cb285/SeniorProject/README.md

# Senior Project
# open source home automation system with raspberry pi, amazon echo, and zigbee mesh communication
