cb285/SeniorProject/hardware/electrical/Hub/Project Outputs for Hub/Hub 1.0 BOM.xlsx

Designator | LibRef | Quantity | Manufacturer | PartNumber | Rating | Value
J3, J4, J5 | J_2POSTERM_1935161 | 3 | Phoenix Contact | 1935161 | 17.5A
D2 | D_RECTBRIDGE_ABS | 1 | SMC Diode Solutions | ABS10TR | 1A
Q1, Q2, Q3 | Q_NFET_SOT23 | 3 | On Semiconductor | BSS138 | 220mA
C3, C4, C5, C6 | C_CAP_0603 | 4 | KEMET | C0603C104K5RACAUTO | 50V | .1uF
C1 | C_CAP-P_EEE-1HA101UP | 1 | Panasonic Electronic Components | EEE-1HA101UP | 50V | 100uF
K1, K2, K3 | K_G6K-2F_G6K-2F | 3 | Omron | G6K-2F-DC3 | 1A
C2 | C_CAP_0603 | 1 | Taiyo Yuden | JMK107ABJ106MA-T | 6.3V | 10uF
U1 | U_LD1117S33TR_SOT223 | 1 | STM | LD1117S33TR | 800mA | 3.3V
U3 | U_TEMPSENSE-AN_TO92 | 1 | Microchip | MCP9700T-E/TT
J2 | J_XBEE_NPPN101BFLC-RC | 1 | Sullins Connector Solutions | NPPN101BFLC-RC | 1A
U2 | U_OKI-78SR-5/1.5-W36H-C_OKI-78SR-5/1.5-W36H-C | 1 | Murata Power Solutions Inc. | OKI-78SR-5/1.5-W36H-C | 1.5A
R4, R5, R6, R7 | R_RES_0603 | 4 | Yageo | RC0603FR-0768RL | 1/10W | 68
R1, R2, R3 | R_RES_0603 | 3 | Yageo | RC0603JR-0710KL | 1/10W | 10K
J1 | J_RPI2B_ SFH11-PBPC-D20-ST-BK | 1 | Sullins Connector Solutions | SFH11-PBPC-D20-ST-BK | 3A
