cb285/SeniorProject/hardware/electrical/LightSwitch/Project Outputs for SeniorProject/Lightswitch 1.1 BOM.xlsx

Designator | LibRef | Quantity | Manufacturer | PartNumber | Rating | Value
C1, C12, C13, C15, C16 | C_CAP_0603 | 5 | Taiyo Yuden | JMK107ABJ106MA-T | 6.3V | 10uF
C2, C3, C4, C5, C6, C7, C9, C10, C11, C14, C17, C19 | C_CAP_0603 | 12 | KEMET | C0603C104K5RACAUTO | 50V | .1uF
C8 | C_CAP_1210 | 1 | Murata | GRM32ER61A107ME20L | 10V | 100uF
C18 | C_CAP-P_CAP12.5X20 | 1 | Nichicon | UVR2D470MHD1TO | 200V | 47uF
C20 | C_CAP_0603 | 1 | AVX Corporation | 06035C102KAT2A | 50V | 1nF
D1, D2 | D_LED_LED5MM | 2
D3, D4, D5, D6, D7, D8, D9, D10, D11, D15 | D_DIODE_SOD123 | 10 | Nexperia USA Inc | BAS16GWJ | 215mA
D12 | D_ZENER_SOD123 | 1 | Diodes Incorporated | BZT52C2V0-7-F | 500mW | 2V
D13 | D_RECTBRIDGE_GBU1506TB | 1 | SMC Diode Solutions | GBU1506TB | 15A
D14 | D_ZENER_SOD323 | 1 | On Semiconductor | MM3Z10VT1G | 300mW | 10V
F1 | F_FUSE_2410 | 1 | Bel Fuse | 0679H9150-05 | 350VAC | 15A
H1, H2, H3, H4, H5, H6 | H_MOUNTHOLE_MOUNTHOLE4MM | 6 |  |  |  | 4mm
J1 | J_RIBBCONN_RIBBCONN | 1
J2 | J_XBEE_NPPN101BFLC-RC | 1 | Sullins Connector Solutions | NPPN101BFLC-RC | 1A
J3, J4 | J_2POSTERM_1935161 | 2 | Phoenix Contact | 1935161 | 17.5A
K1 | K_RELAY-RZ03-1A4_RZ03-1A4-D005 | 1 | TE Connectivity / Potter and Brumfield | RZ03-1A4-D005 | 16A
Q1 | Q_NFET_SOT23 | 1 | On Semiconductor | BSS138 | 220mA
Q2 | Q_NFET_TO252 | 1 | Infineon Technologies | IPD50R280CEAUMA1 | 18.1A
R1 | R_RES_0603 | 1 | Yageo | RC0603JR-07470KL | 1/10W | 470K
R2, R4, R5, R6, R8, R10, R11, R12, R17, R20 | R_RES_0603 | 10 | Yageo | RC0603JR-0710KL | 1/10W | 10K
R3, R9, R18 | R_RES_0603 | 3 | Yageo | RC0603JR-07180RL | 1/10W | 180
R7, R19 | R_RES_0603 | 2 | Yageo | RC0603FR-07806KL | 1/10W | 806K
R13, R22 | R_RES_0603 | 2 | Yageo | RC0603FR-07196KL | 1/10W | 196K
R14, R23 | R_RES_0603 | 2 | Yageo | RC0603FR-071K62L | 1/10W | 1.62K
R15 | R_RES_0603 | 1 | Yageo | RC0603FR-071ML | 1/10W | 1M
R16 | R_RES_0603 | 1 | Yageo | RC0603FR-07280KL | 1/10W | 280K
R21 | R_RES_0603 | 1 | Yageo | RC0603FR-072K49L | 1/10W | 2.49K
R24 | R_RES_1206 | 1 | Yageo | RC1206JR-07100KL | 1/4W | 100K
T1, T2, T3, T4, T5, T6, T8, T9, T12, T13, T15, T17, T18, T19, T20, T21, T22, T23, T24, T25 | T_TESTPOINT_TESTPOINT1MM | 20 |  |  |  | 1mm
T7, T10, T11, T14, T16 | T_TESTPOINT_TESTPOINT2.5MM | 5 |  |  |  | 2.54mm
U1 | U_DUALDFLIP_SOIC14 | 1 | TI | SN74HCT74DR
U2 | U_DS4301_MSOP8 | 1 | Maxim | DS4301 |  | 200K
U3 | U_SN74HCT04DR_SOIC14 | 1 | TI | SN74HCT04DR
U4 | U_LTC6992CS6-2_SOT23-6 | 1 | Linear | LTC6992CS6-2
U5 | U_LD1117S33TR_SOT223 | 1 | STM | LD1117S33TR | 800mA | 3.3V
U6 | U_MCT275_DIP6 | 1 | Vishay | MCT275
U7 | U_ACS712_SOIC8 | 1 | Allegro MicroSystems, LLC | ACS712ELCTR-20A-T | 20A
U8 | U_IRM-02-5_IRM-02-5 | 1 |  | IRM-02-5 | 400mA | 5V
