cb285/SeniorProject/hardware/electrical/Hub/Models/EEE-1HA101UP.STEP

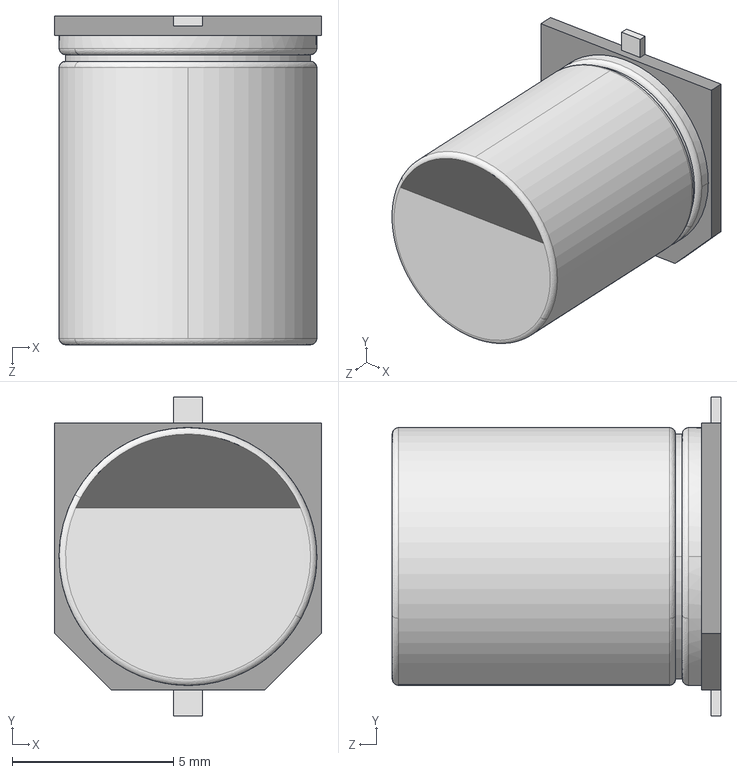
[picture p1: CAD file, 2018-03-21]
hardware/electrical/Hub/Models/EEE-1HA101UP.STEP
8.30 x 9.90 x 10.2 mm
