cb285/SeniorProject/hardware/electrical/LightSwitch/Models/IRM-02-5.stp

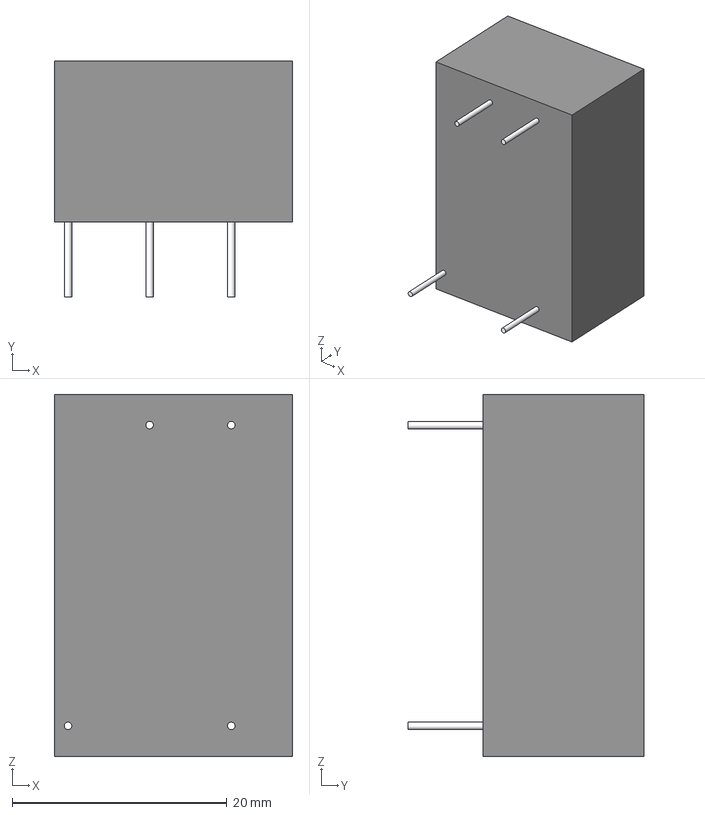
[picture p2: CAD file, 2018-03-12]
hardware/electrical/LightSwitch/Models/IRM-02-5.stp
22.2 x 22.0 x 33.7 mm
