cb285/SeniorProject/hardware/mechanical/Hub/Hub Enclosure Front 1.1.stl

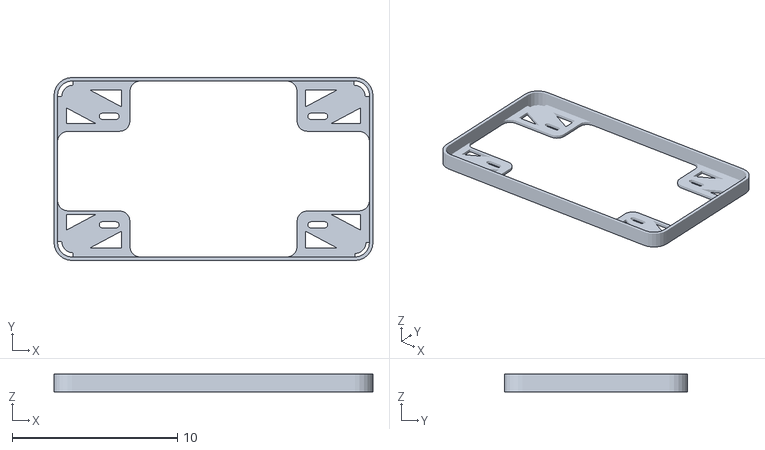
[picture p3: CAD file, 2018-04-02]
hardware/mechanical/Hub/Hub Enclosure Front 1.1.stl
19.3 x 11.1 x 1.06
