cb285/SeniorProject/hardware/mechanical/LightSwitch/LightSwitchCover 1.1.stl

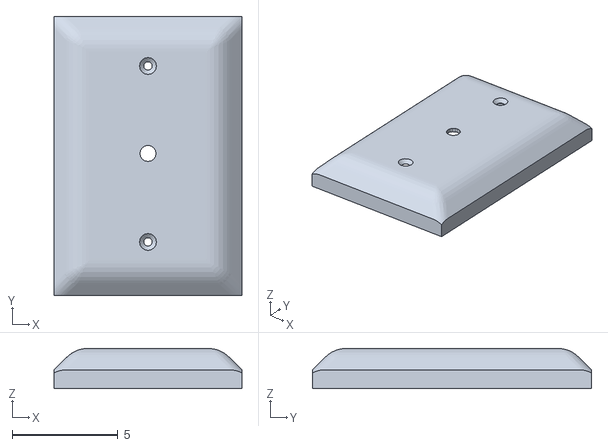
[picture p4: CAD file, 2018-03-27]
hardware/mechanical/LightSwitch/LightSwitchCover 1.1.stl
8.89 x 13.2 x 1.90
