cb285/SeniorProject/hardware/electrical/Hub/Models/ABS.step

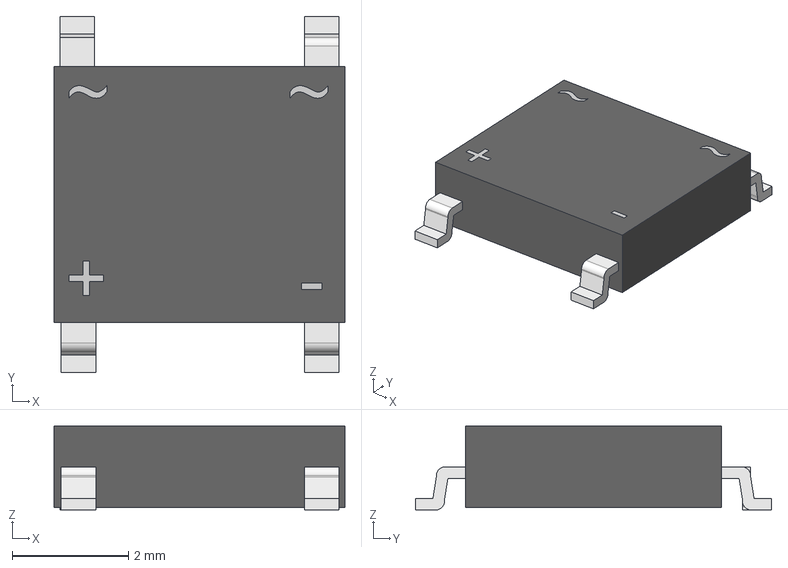
[picture p5: CAD file, 2018-03-21]
hardware/electrical/Hub/Models/ABS.step
5.00 x 6.12 x 1.46 mm
Würfel
Würfel002
Würfel003
Würfel001
ShapeString
ShapeString001
ShapeString002
ShapeString003
