cb285/SeniorProject/hardware/electrical/LightSwitch/Models/SOD323.stp

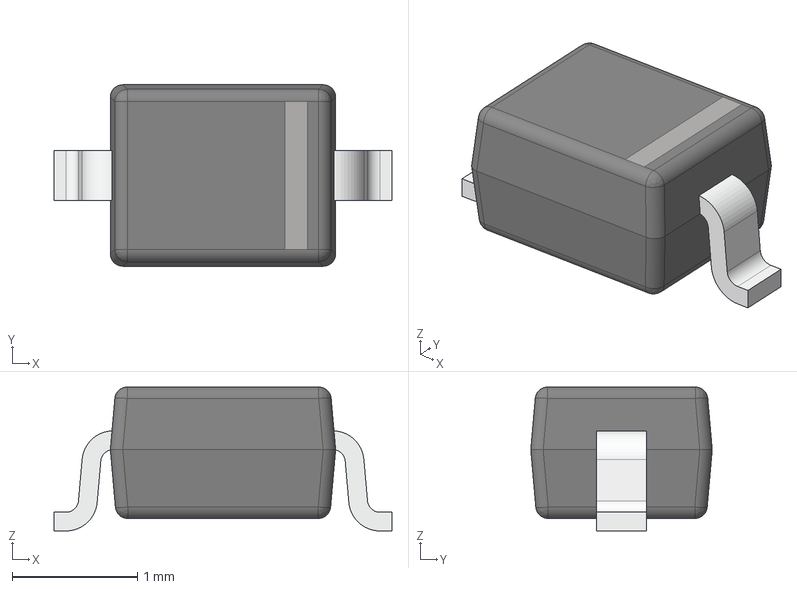
[picture p6: CAD file, 2018-03-12]
hardware/electrical/LightSwitch/Models/SOD323.stp
2.70 x 1.45 x 1.15 mm
