cb285/SeniorProject/hardware/mechanical/LightSwitch/EncoderDaughter.step

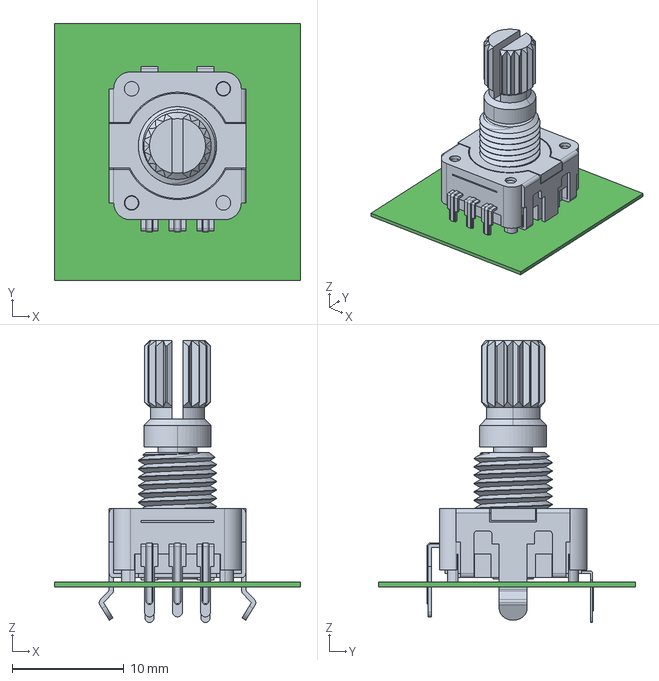
[picture p8: CAD file, 2018-03-16]
hardware/mechanical/LightSwitch/EncoderDaughter.step
22.0 x 23.0 x 25.2 mm
Board
pec11r-4215k-n0024
