cb285/SeniorProject/hardware/electrical/Hub/Models/G6K_2F.step

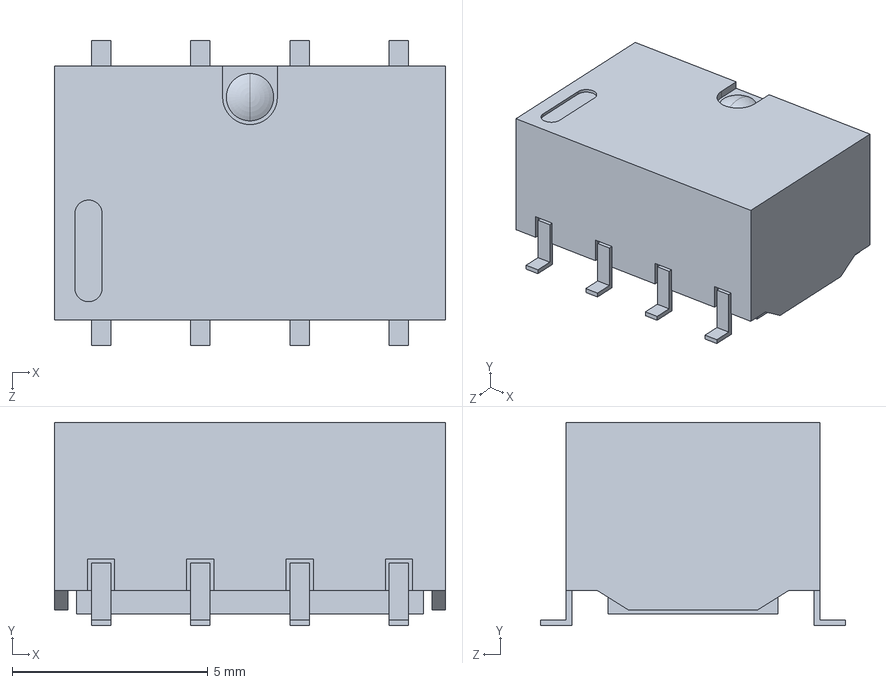
[picture p9: CAD file, 2018-03-21]
hardware/electrical/Hub/Models/G6K_2F.step
10.0 x 5.20 x 7.80 mm
