cb285/SeniorProject/hardware/electrical/LightSwitch/Models/0679H.stp

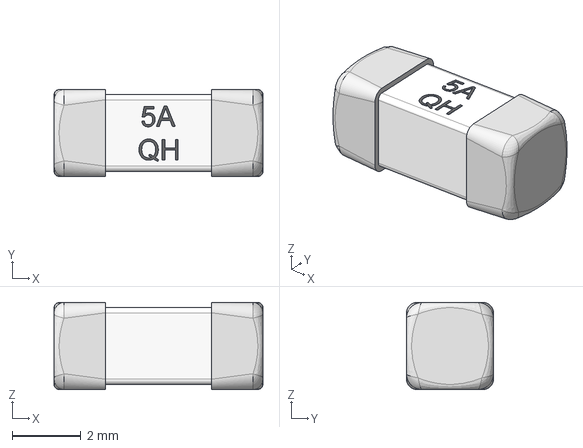
[picture p10: CAD file, 2018-03-12]
hardware/electrical/LightSwitch/Models/0679H.stp
6.10 x 2.54 x 2.54 mm
