cb285/SeniorProject/hardware/electrical/Hub/Models/OKI-78SR-51.5-W36H-C.step

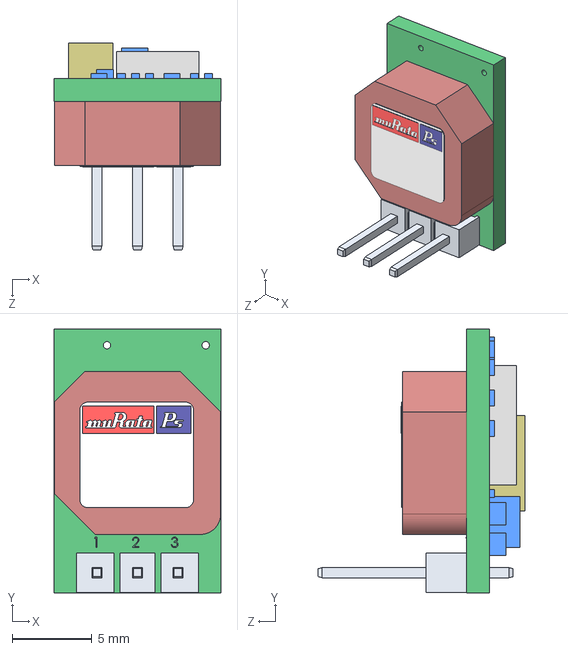
[picture p12: CAD file, 2018-03-21]
hardware/electrical/Hub/Models/OKI-78SR-51.5-W36H-C.step
10.4 x 16.5 x 12.9 mm
