cb285/SeniorProject/hardware/electrical/LightSwitch/Models/LED5MM.STEP

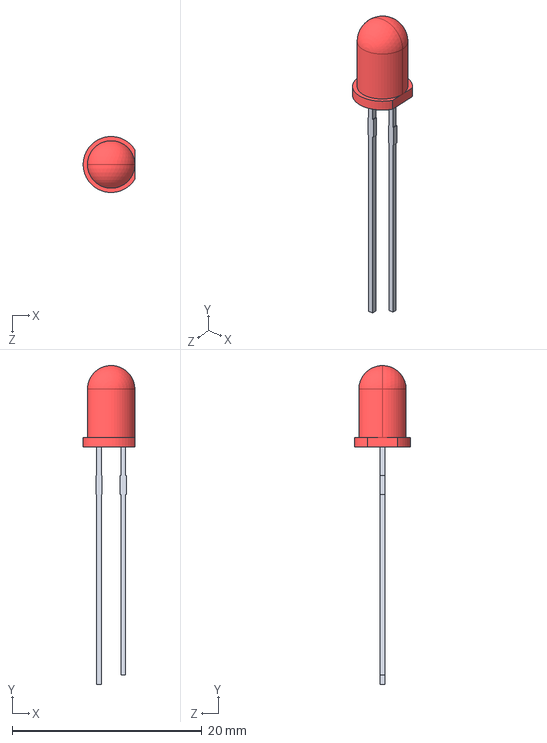
[picture p13: CAD file, 2018-03-12]
hardware/electrical/LightSwitch/Models/LED5MM.STEP
5.45 x 33.6 x 5.90 mm
