cb285/SeniorProject/hardware/mechanical/LightSwitch/1GangSwitchBox.STEP

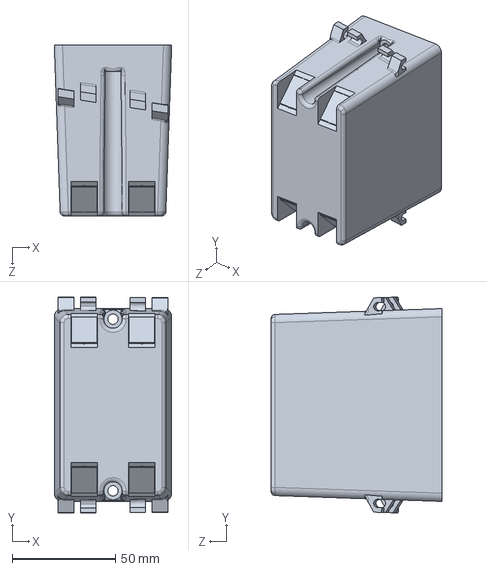
[picture p14: CAD file, 2018-03-12]
hardware/mechanical/LightSwitch/1GangSwitchBox.STEP
57.0 x 104.8 x 82.9 mm
