cb285/SeniorProject/hardware/electrical/Hub/Models/DO15.STEP

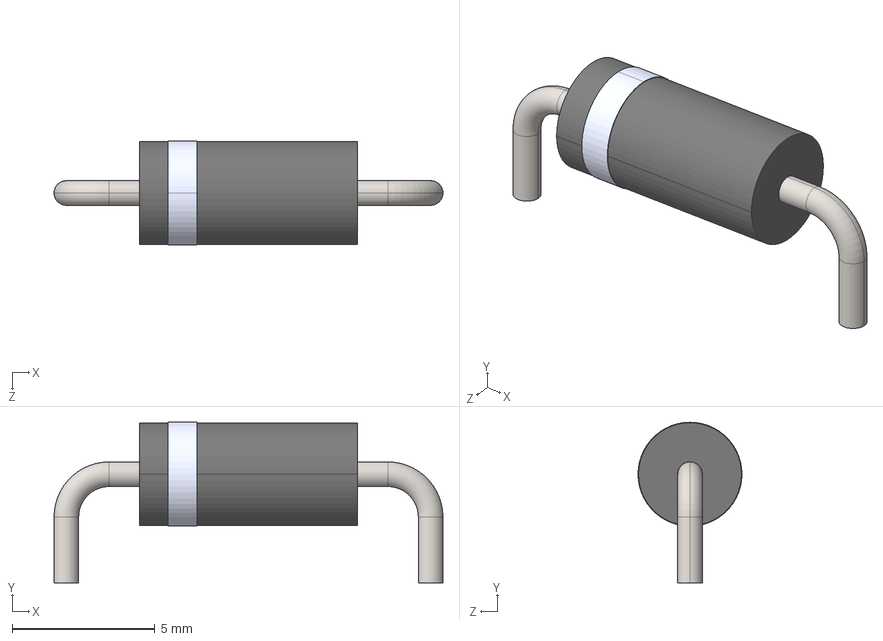
[picture p15: CAD file, 2018-03-21]
hardware/electrical/Hub/Models/DO15.STEP
13.6 x 5.62 x 3.64 mm
