cb285/SeniorProject/hardware/electrical/LightSwitch/Models/RZ03-1A4-D005.stp

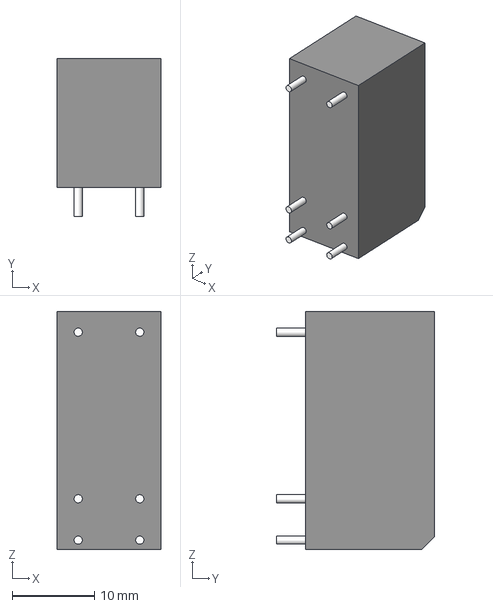
[picture p16: CAD file, 2018-03-12]
hardware/electrical/LightSwitch/Models/RZ03-1A4-D005.stp
12.7 x 19.2 x 29.0 mm
