cb285/SeniorProject/hardware/mechanical/LightSwitch/PEC11-4215F-S24.stp

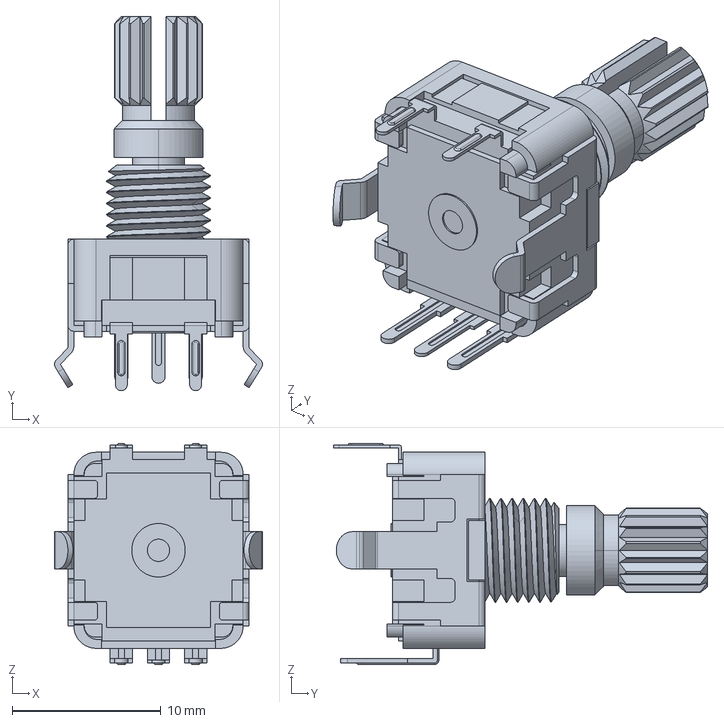
[picture p17: CAD file, 2018-02-16]
hardware/mechanical/LightSwitch/PEC11-4215F-S24.stp
14.0 x 25.2 x 14.9 mm
