cb285/SeniorProject/hardware/electrical/Hub/Models/CAP10X20.step

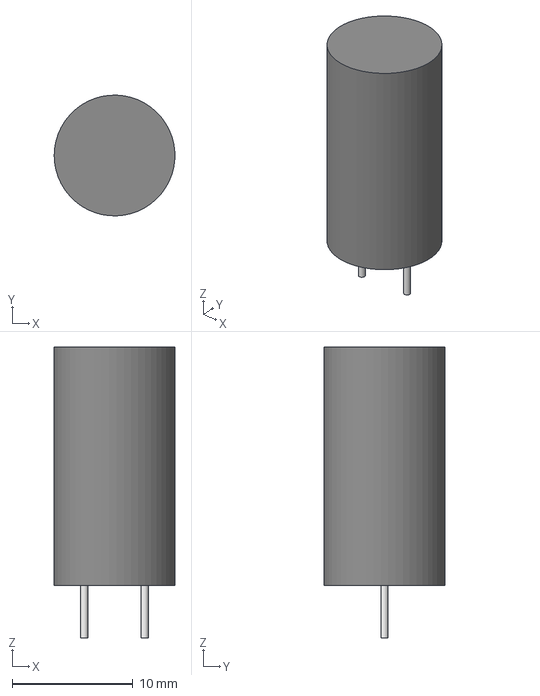
[picture p18: CAD file, 2018-03-17]
hardware/electrical/Hub/Models/CAP10X20.step
10.00 x 10.0 x 24.1 mm
