cb285/SeniorProject/hardware/electrical/LightSwitch/Models/AC1015.stp

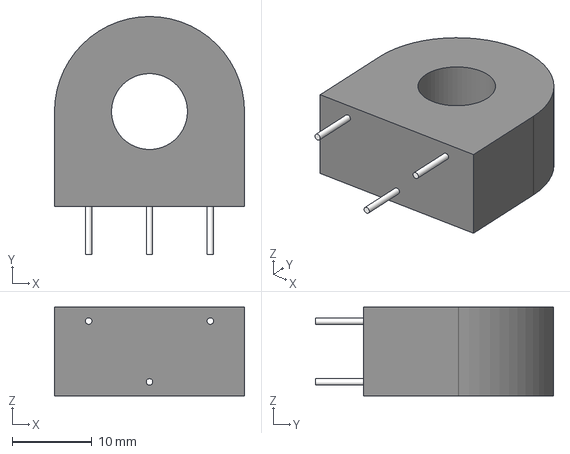
[picture p19: CAD file, 2018-03-12]
hardware/electrical/LightSwitch/Models/AC1015.stp
23.8 x 29.8 x 11.1 mm
