cb285/SeniorProject/hardware/electrical/Hub/Models/SIOC8.stp

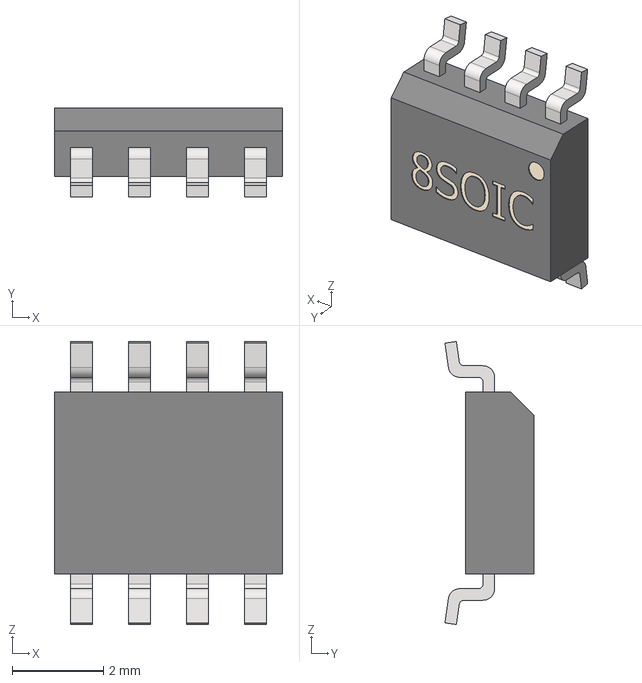
[picture p20: CAD file, 2018-03-17]
hardware/electrical/Hub/Models/SIOC8.stp
5.00 x 1.95 x 6.20 mm
8SOIC_BODY
8SOIC_PIN x 8
