cb285/SeniorProject/hardware/electrical/LightSwitch/Models/SOT23.step

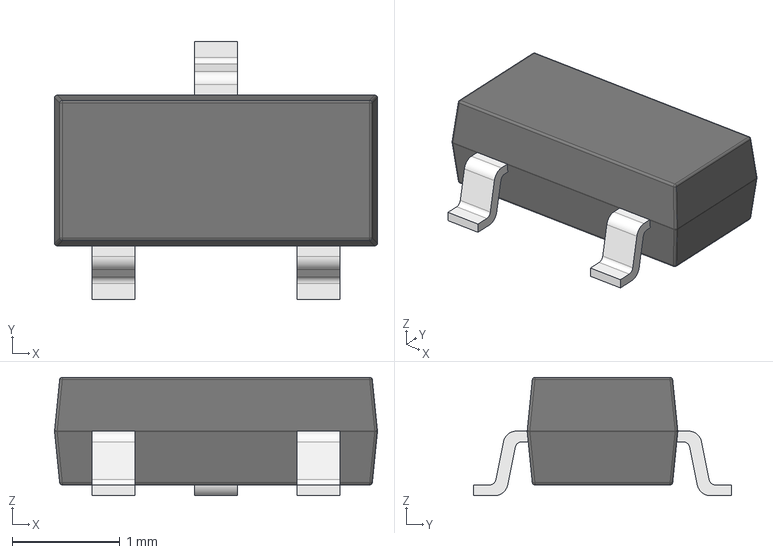
[picture p21: CAD file, 2018-03-12]
hardware/electrical/LightSwitch/Models/SOT23.step
3.00 x 2.40 x 1.10 mm
pin x 3
