cb285/SeniorProject/hardware/electrical/LightSwitch/Models/NPPN101BFLC-RC.STEP

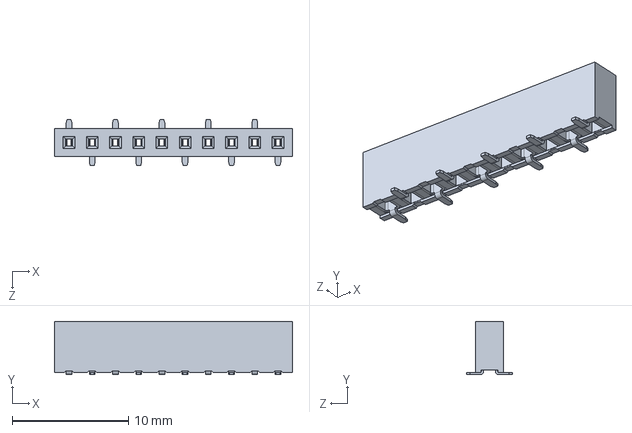
[picture p22: CAD file, 2018-03-12]
hardware/electrical/LightSwitch/Models/NPPN101BFLC-RC.STEP
20.5 x 4.60 x 4.00 mm
