cb285/SeniorProject/hardware/electrical/LightSwitch/Models/SOD123.stp

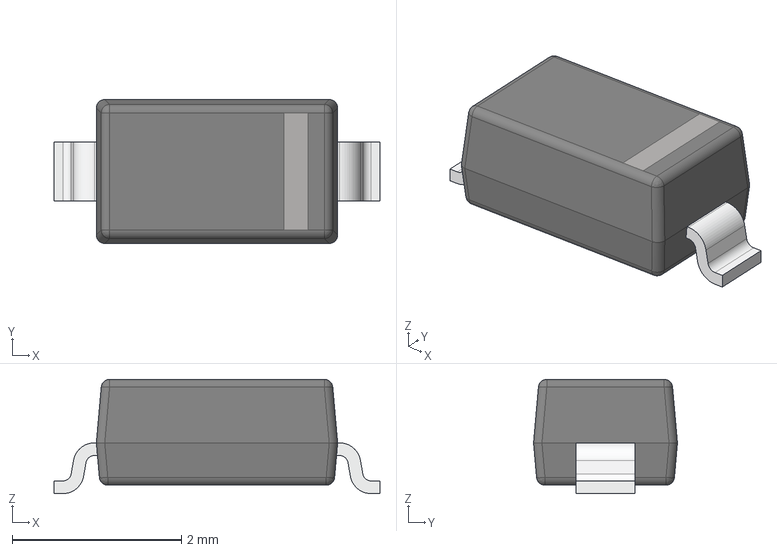
[picture p23: CAD file, 2018-03-12]
hardware/electrical/LightSwitch/Models/SOD123.stp
3.85 x 1.70 x 1.35 mm
