cb285/SeniorProject/hardware/electrical/LightSwitch/Models/GBU.STEP

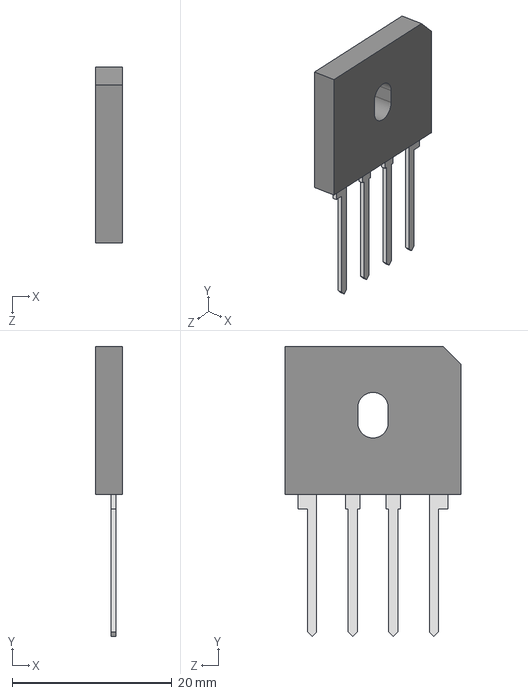
[picture p24: CAD file, 2018-03-12]
hardware/electrical/LightSwitch/Models/GBU.STEP
3.43 x 36.3 x 22.1 mm
