cb285/SeniorProject/hardware/electrical/LightSwitch/Models/SOIC14.stp

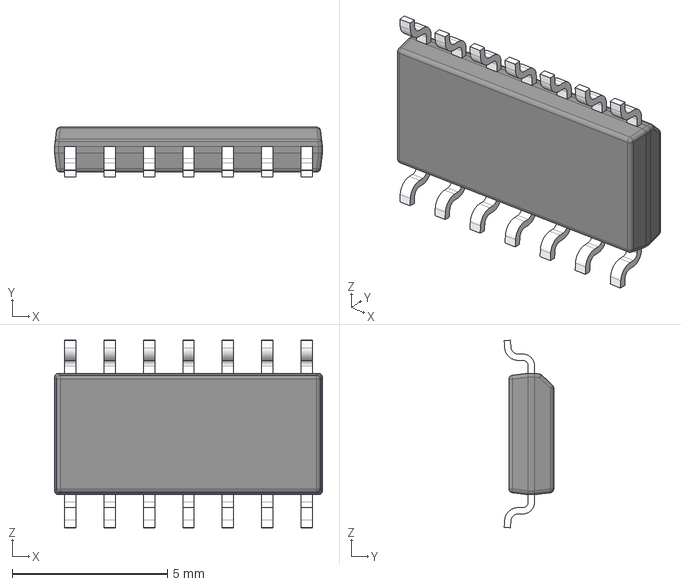
[picture p25: CAD file, 2018-03-12]
hardware/electrical/LightSwitch/Models/SOIC14.stp
8.64 x 1.60 x 6.05 mm
BODY_M14A_20
LEAD_M14A_46 x 14
