cb285/SeniorProject/hardware/electrical/LightSwitch/Models/RES1206.STEP

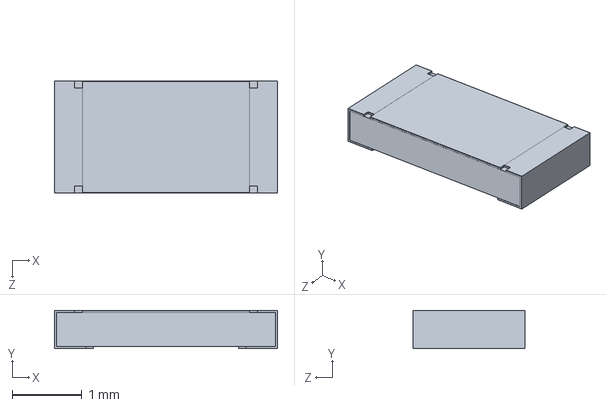
[picture p26: CAD file, 2018-02-21]
hardware/electrical/LightSwitch/Models/RES1206.STEP
3.20 x 0.55 x 1.61 mm
