cb285/SeniorProject/hardware/electrical/LightSwitch/Models/DIP16-4.stp

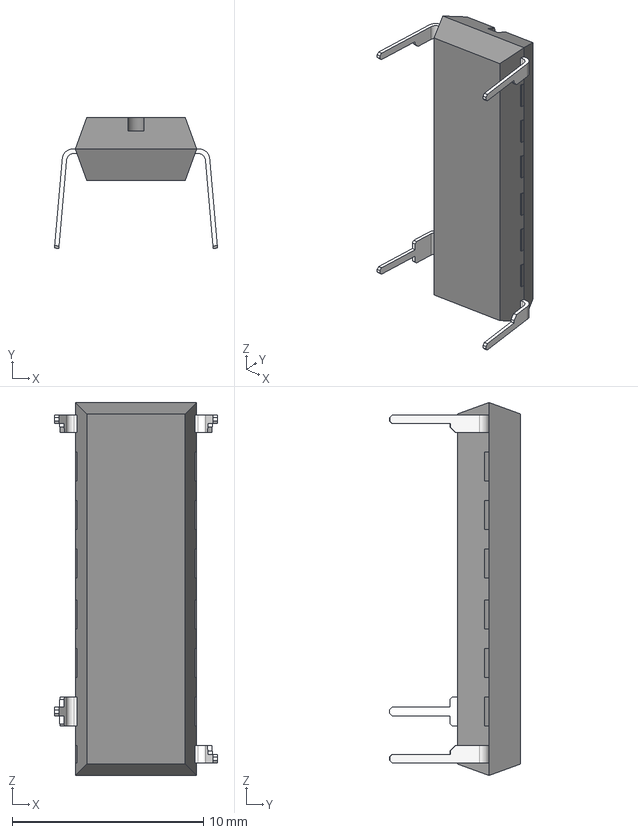
[picture p27: CAD file, 2018-02-21]
hardware/electrical/LightSwitch/Models/DIP16-4.stp
8.53 x 6.85 x 19.5 mm
