cb285/SeniorProject/hardware/electrical/LightSwitch/Models/msop-8.SLDPRT

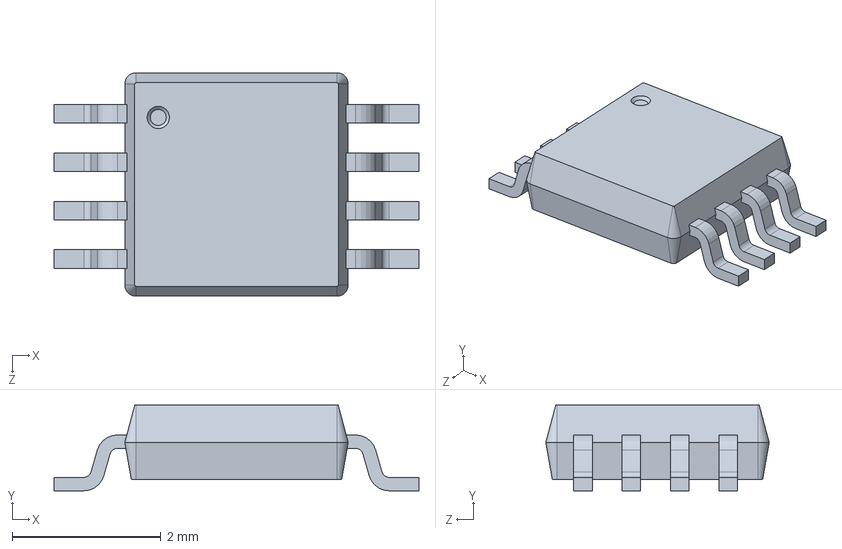
[picture p28: CAD file, 2018-02-21]
hardware/electrical/LightSwitch/Models/msop-8.SLDPRT
4.90 x 1.15 x 3.00 mm
