cb285/SeniorProject/hardware/electrical/LightSwitch/Models/CAP12.5X20.stp

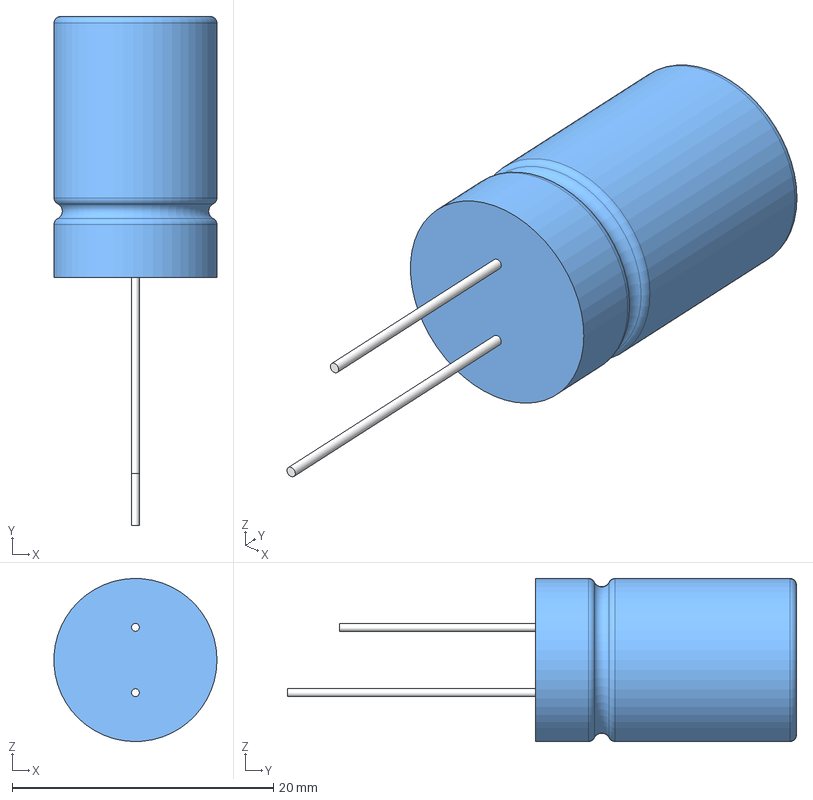
[picture p29: CAD file, 2018-02-21]
hardware/electrical/LightSwitch/Models/CAP12.5X20.stp
12.5 x 39.0 x 12.5 mm
