cb285/SeniorProject/hardware/electrical/LightSwitch/Models/0603.STEP

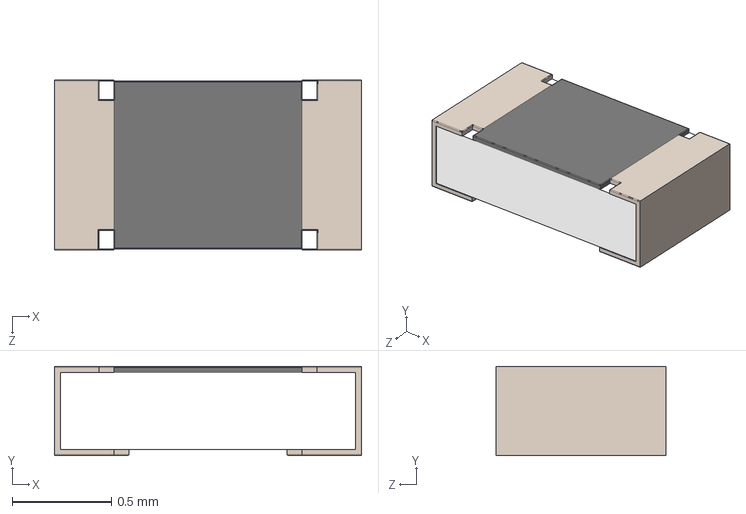
[picture p30: CAD file, 2018-02-21]
hardware/electrical/LightSwitch/Models/0603.STEP
1.55 x 0.45 x 0.86 mm
