cb285/SeniorProject/(list of files, cad)

Other CAD files:
hardware/mechanical/LightSwitch/LightSwitchCover 1.0.stl
hardware/mechanical/Hub/Hub Enclosure Front 1.0.stl
hardware/electrical/LightSwitch/Models/AC1015.ipt
hardware/electrical/LightSwitch/Models/CAP12.5X20.ipt
hardware/electrical/LightSwitch/Models/DIP16-4.ipt
hardware/electrical/LightSwitch/Models/IRM-02-5.ipt
hardware/electrical/LightSwitch/Models/RZ03-1A4-D005.ipt
hardware/electrical/LightSwitch/Models/m20-9980345_asm.stp
hardware/mechanical/Hub/1GangSwitchBox.ipt
hardware/mechanical/Hub/Hub Enclosure Back.ipt
hardware/mechanical/Hub/Hub Enclosure Front (new).ipt
hardware/mechanical/Hub/Hub Enclosure Front.ipt
hardware/mechanical/Hub/Standoff.ipt
hardware/mechanical/Hub/Touchscreen PCB.ipt
hardware/mechanical/Hub/Touchscreen.ipt
hardware/mechanical/LightSwitch/LightSwitchCover.ipt
hardware/mechanical/LightSwitchAssembly.iam
