cb285/SeniorProject/hardware/mechanical/Hub/HubAssembly-Exploded.png

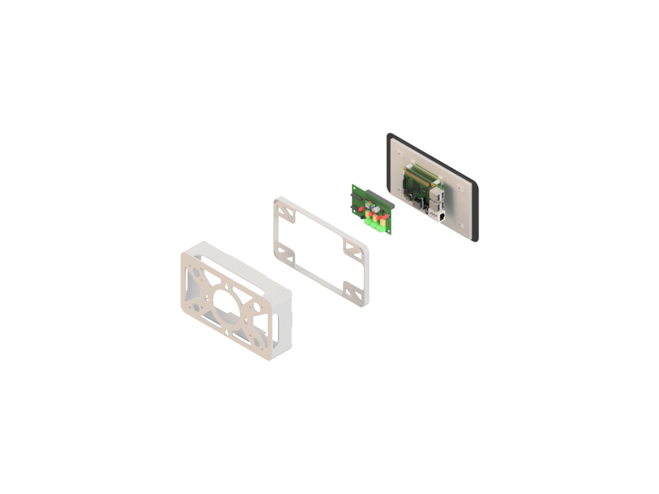
hardware/mechanical/Hub/HubAssembly-Exploded.png
