cb285/SeniorProject/hardware/mechanical/Hub/HubAssembly.png

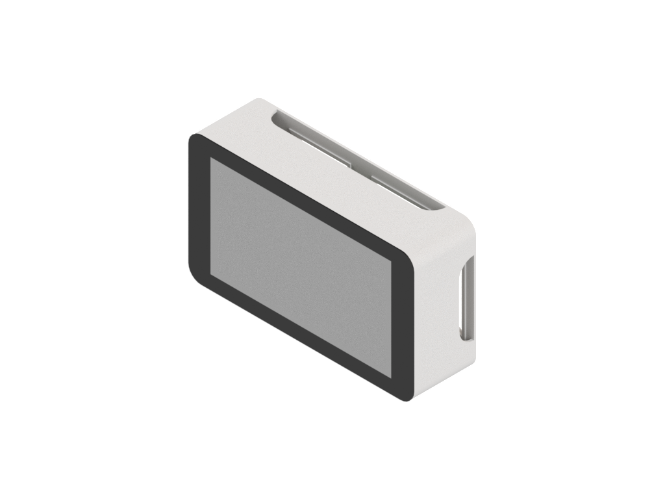
hardware/mechanical/Hub/HubAssembly.png
