cb285/SeniorProject/hardware/mechanical/LightSwitch/LightSwitchAssembly-Exploded.png

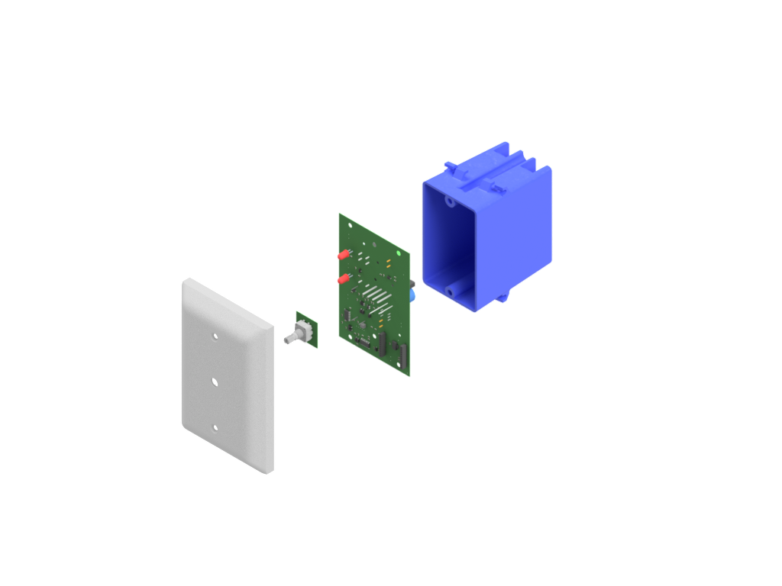
hardware/mechanical/LightSwitch/LightSwitchAssembly-Exploded.png
