cb285/SeniorProject/hardware/mechanical/LightSwitch/LightSwitchAssembly.png

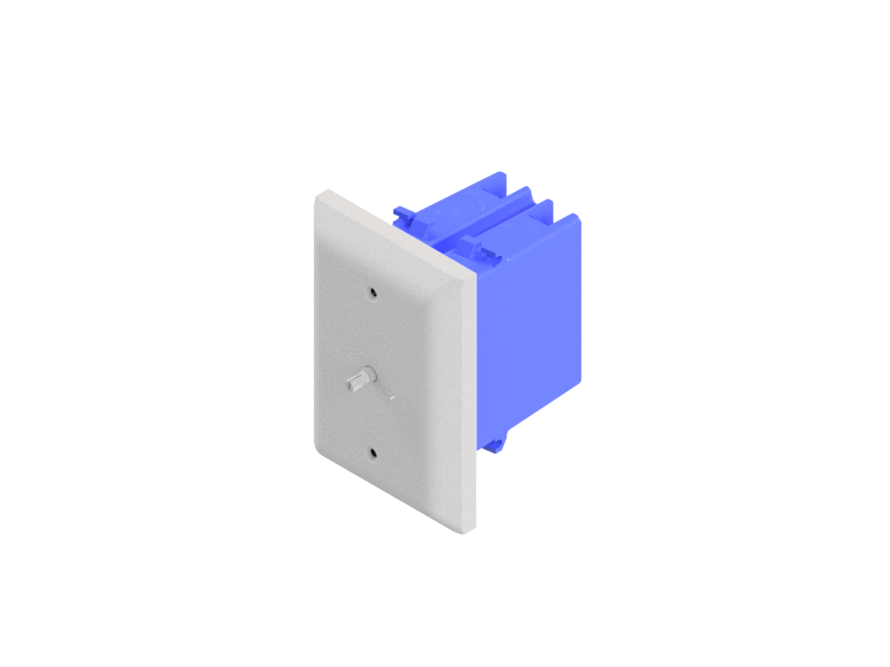
hardware/mechanical/LightSwitch/LightSwitchAssembly.png
