cb285/SeniorProject/hardware/electrical/Hub/Project Outputs for Hub/Hub.PDF

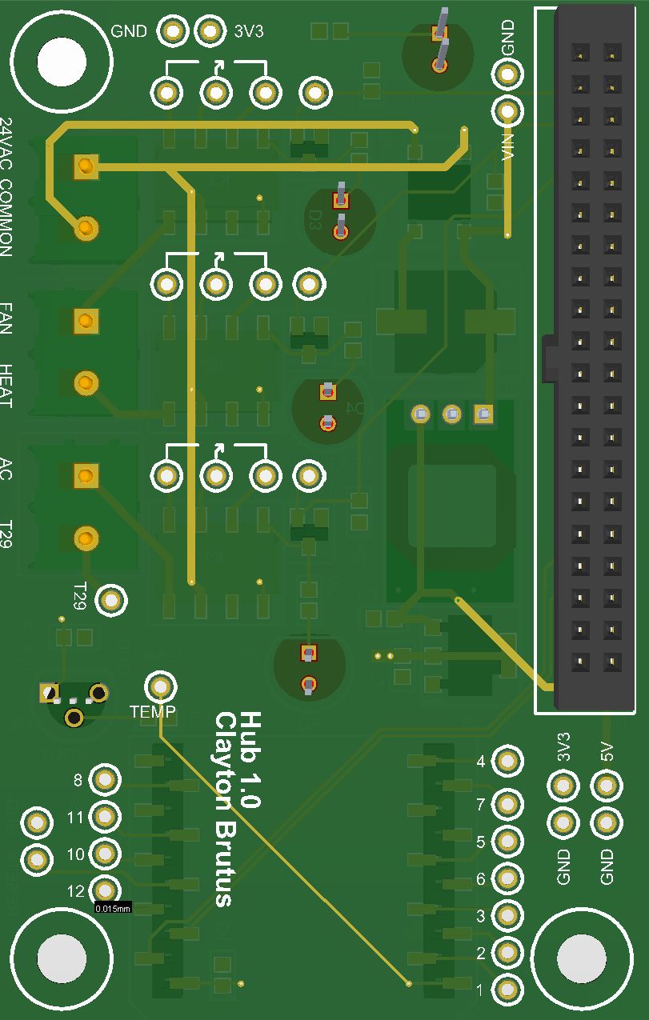
[picture p35: page 1]

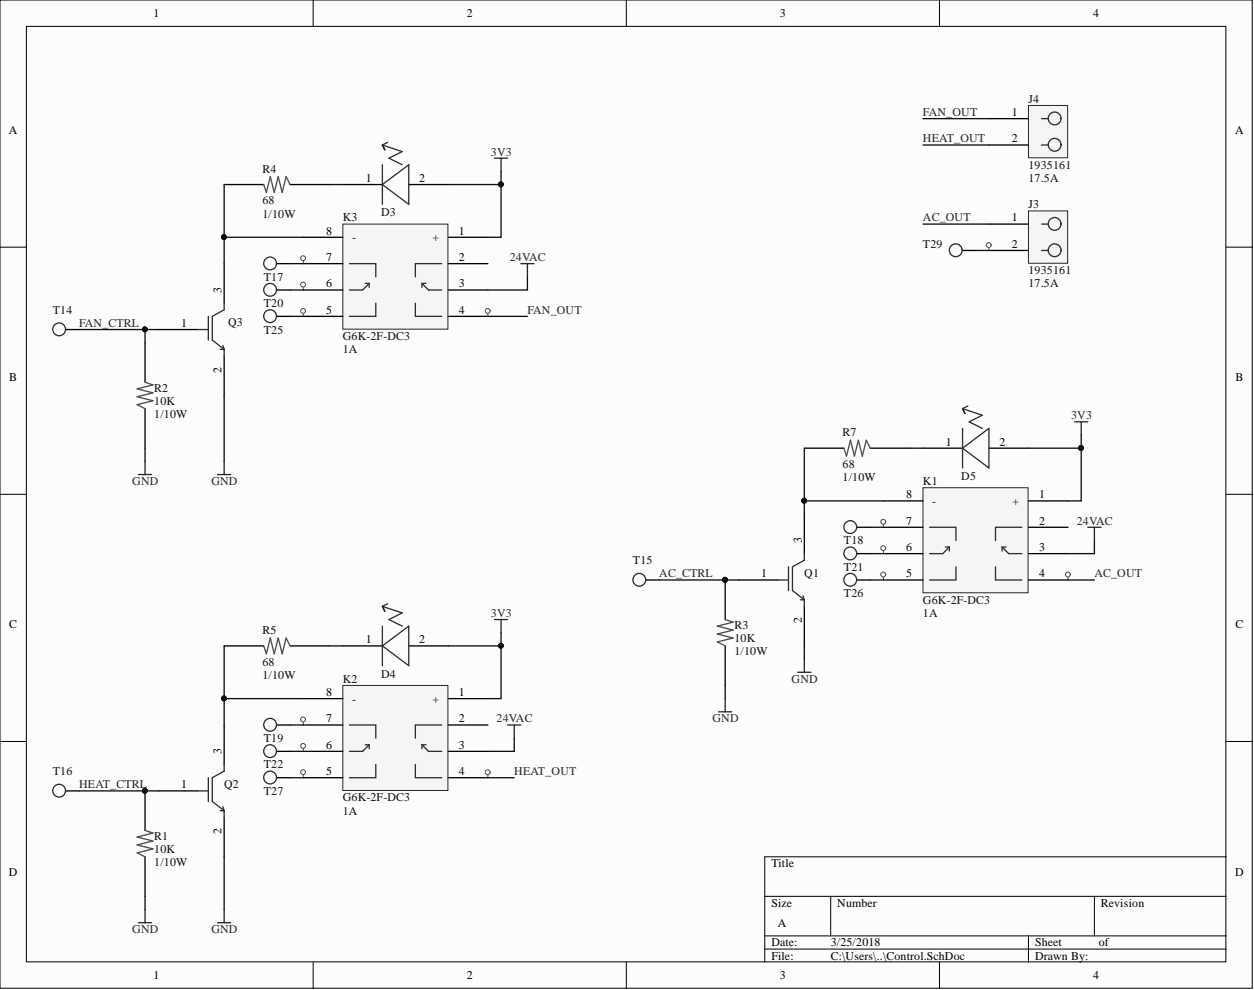
[picture p36: page 3]

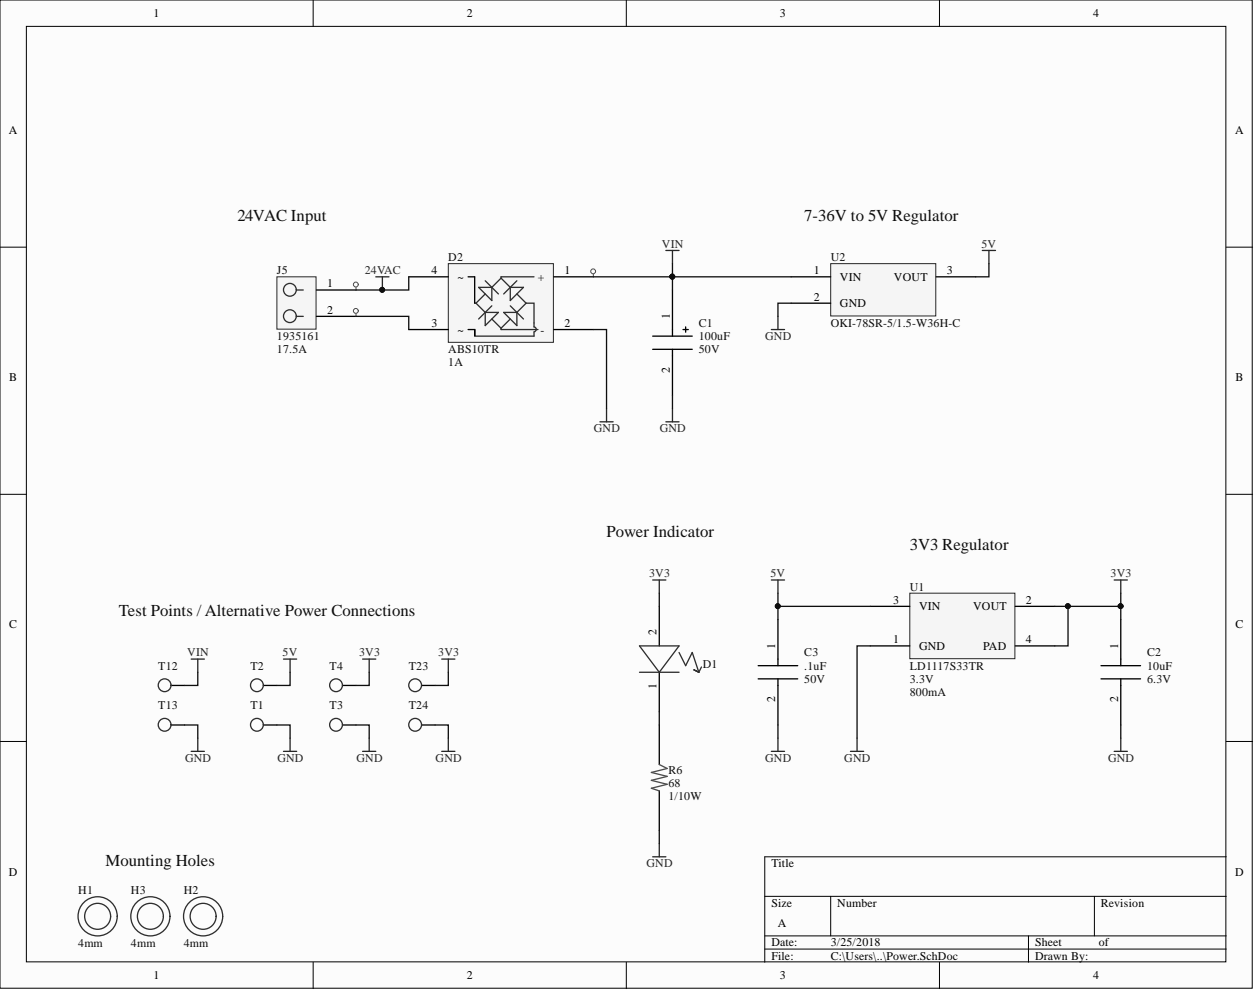
[picture p37: page 4]

Test Points / Alternative Power Connections

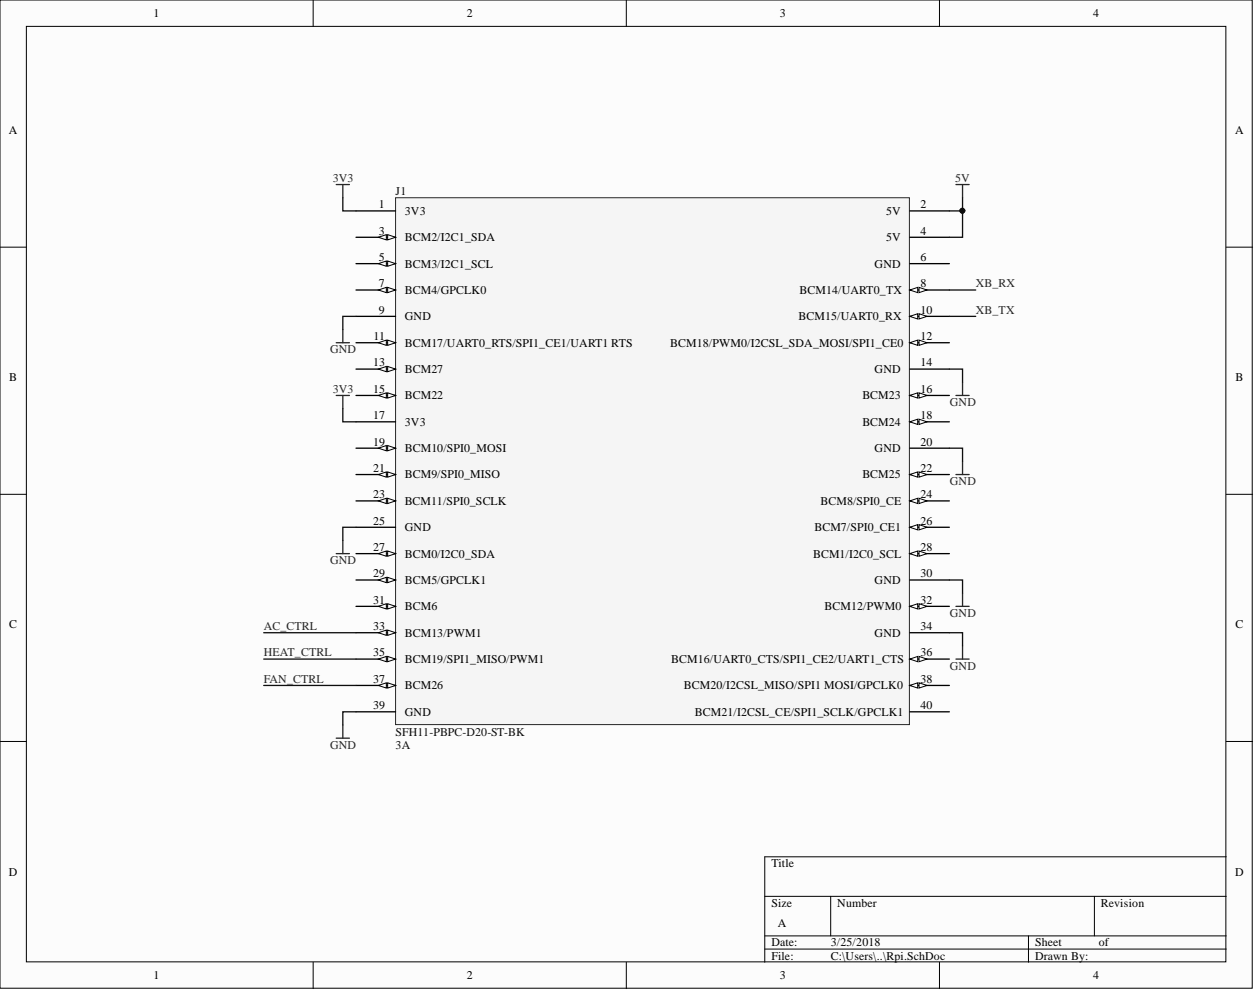
[picture p38: page 5]

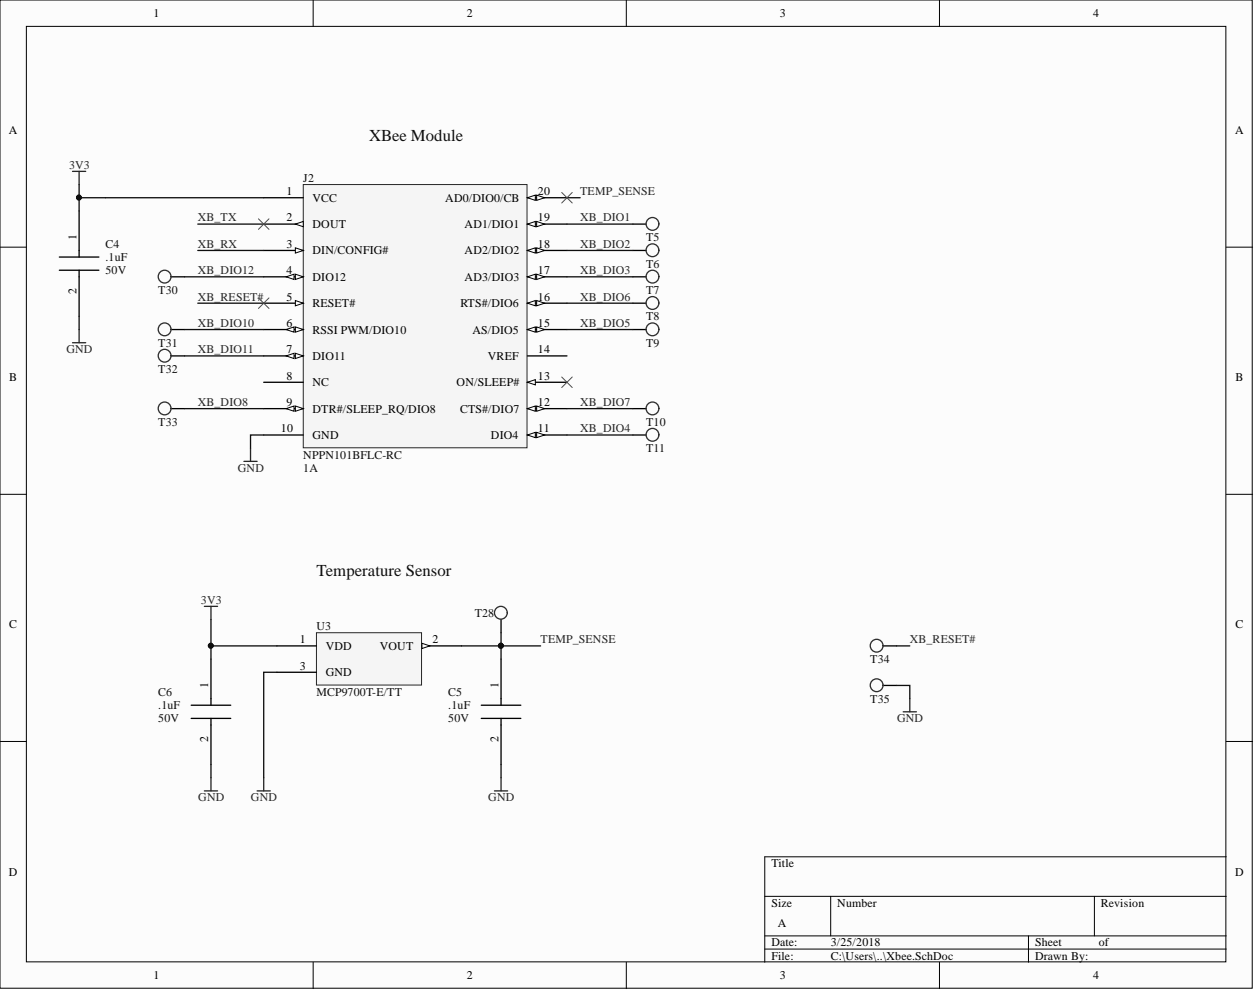
[picture p39: page 6]

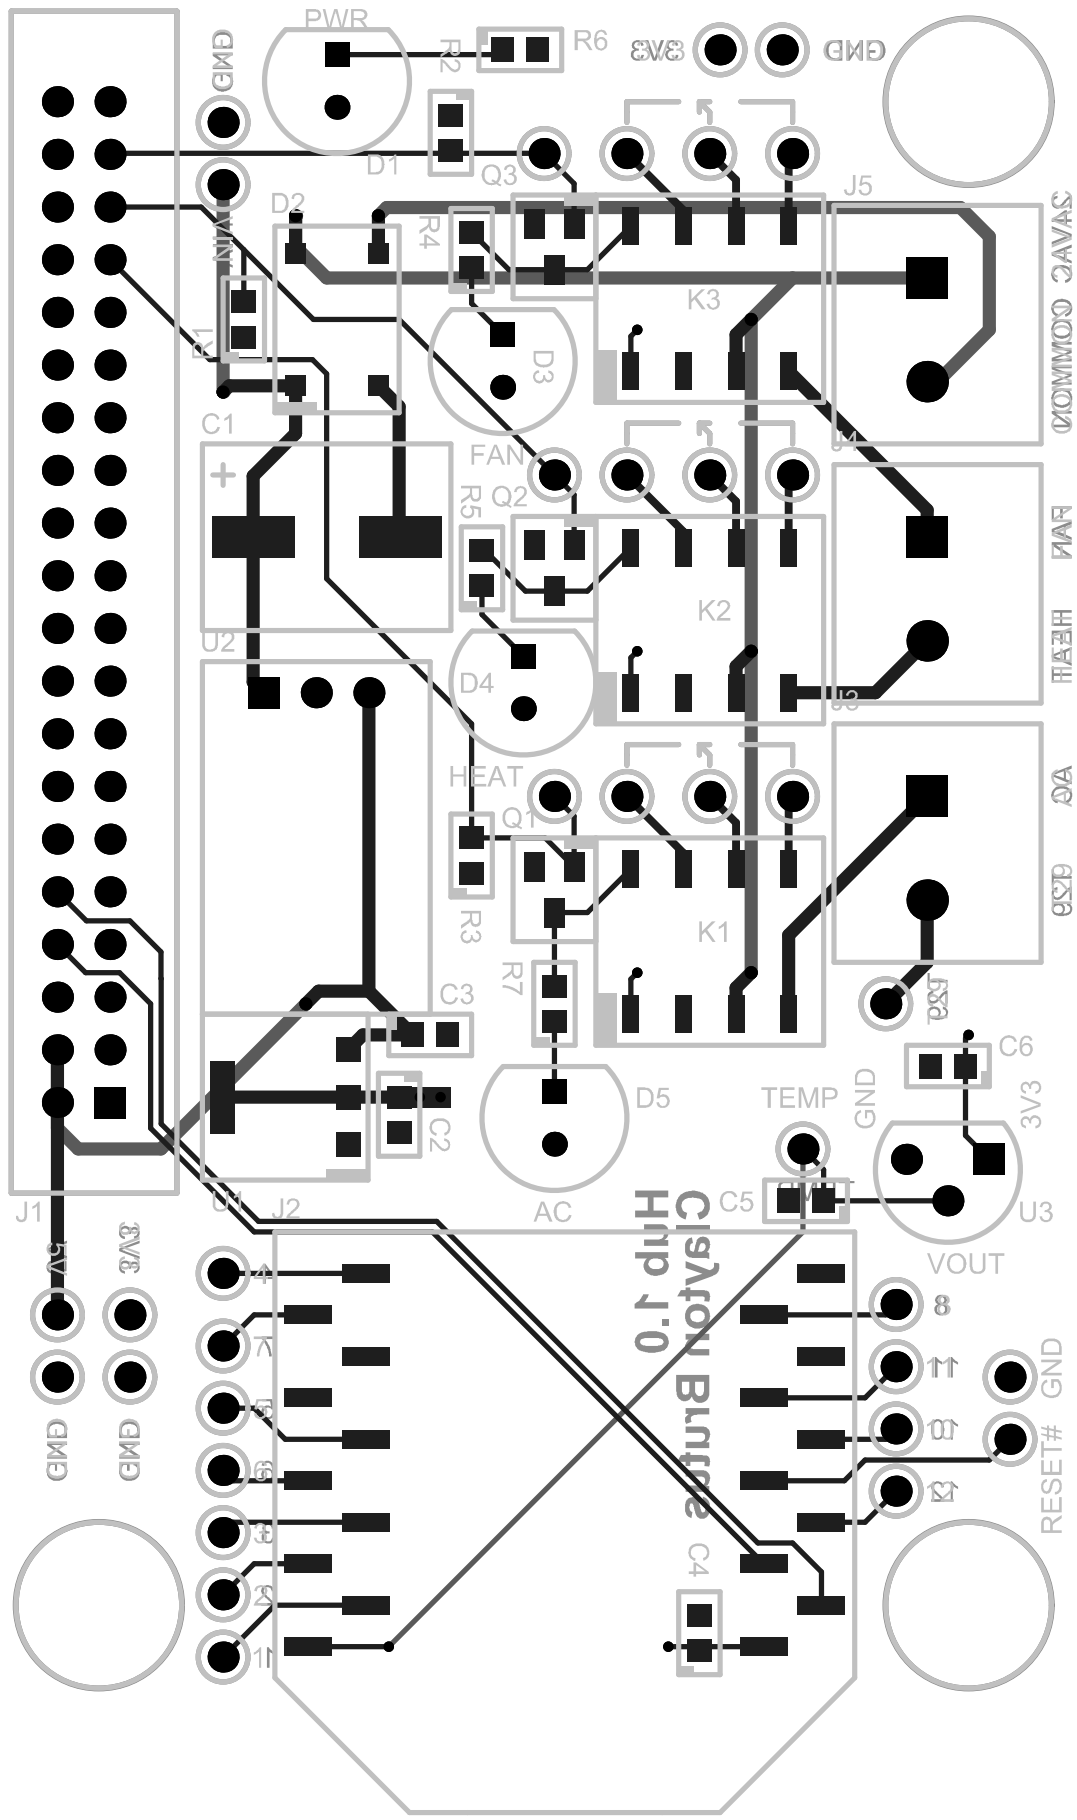
[picture p40: page 7]
