cb285/SeniorProject/hardware/electrical/Hub/Project Outputs for Hub/Schematic Print/Schematic Prints.PDF

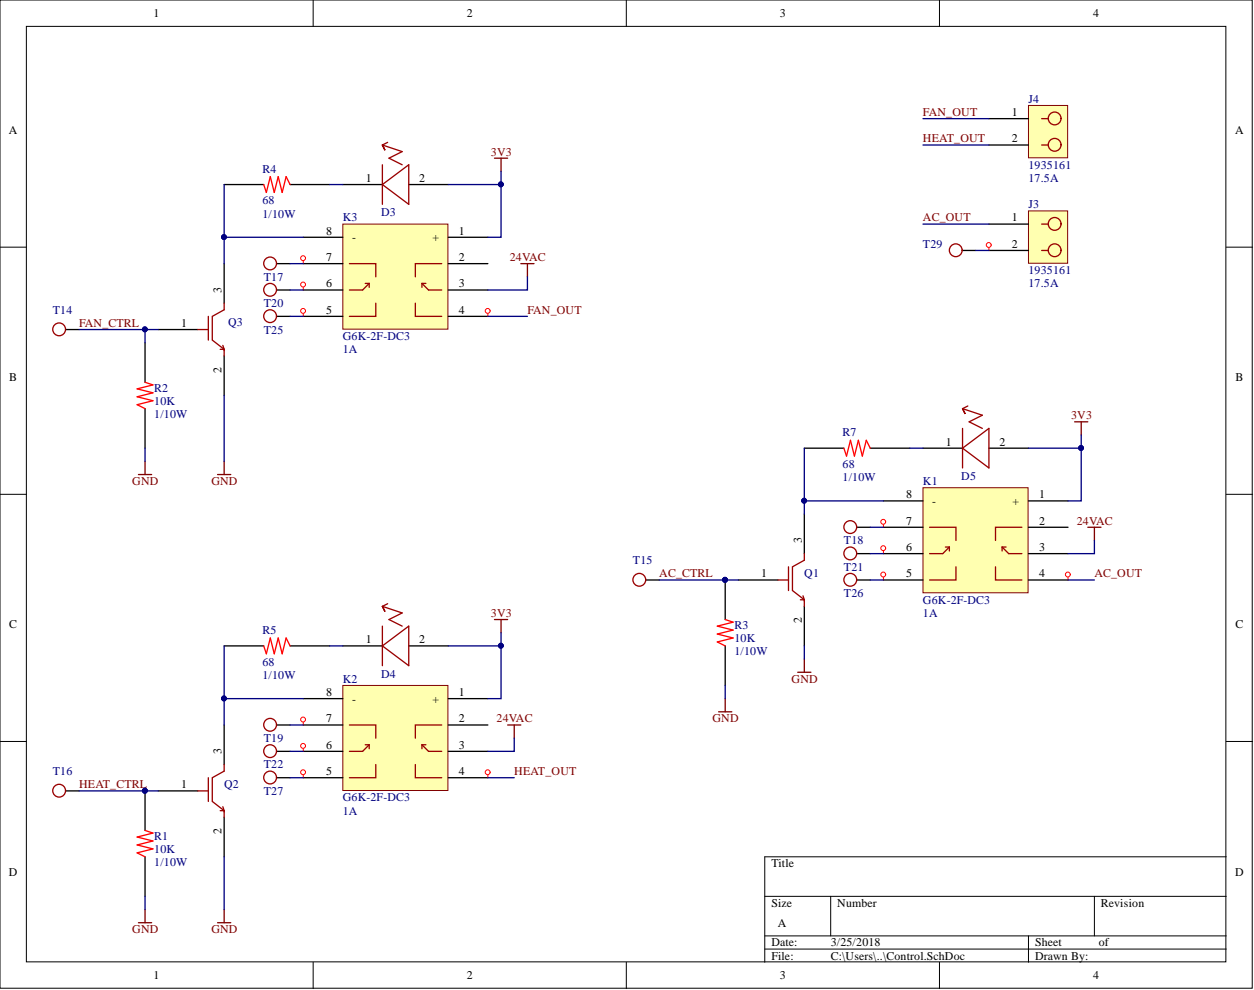
[picture p41: page 1]

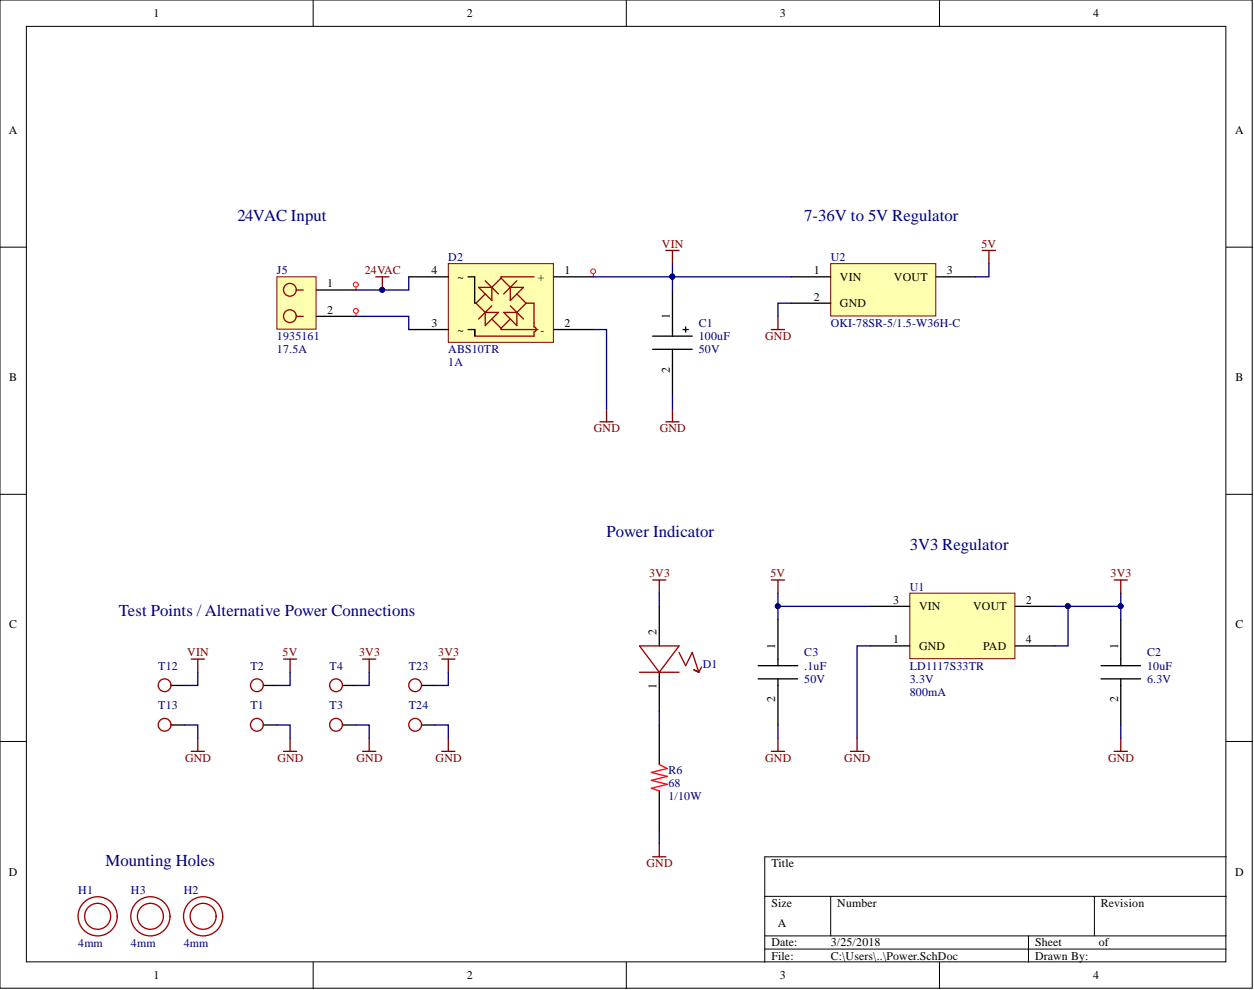
[picture p42: page 2]

Test Points / Alternative Power Connections

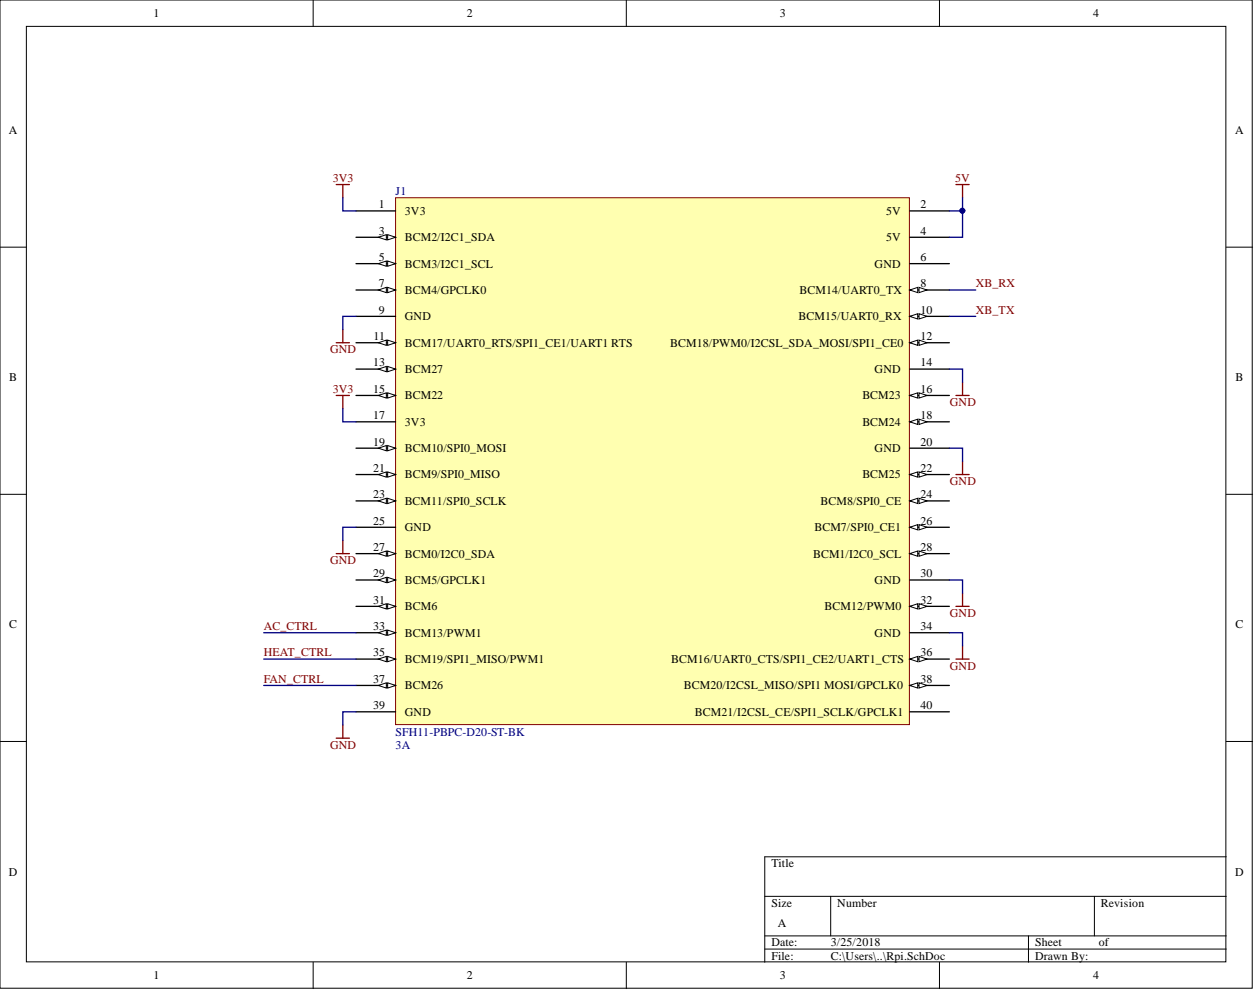
[picture p43: page 3]

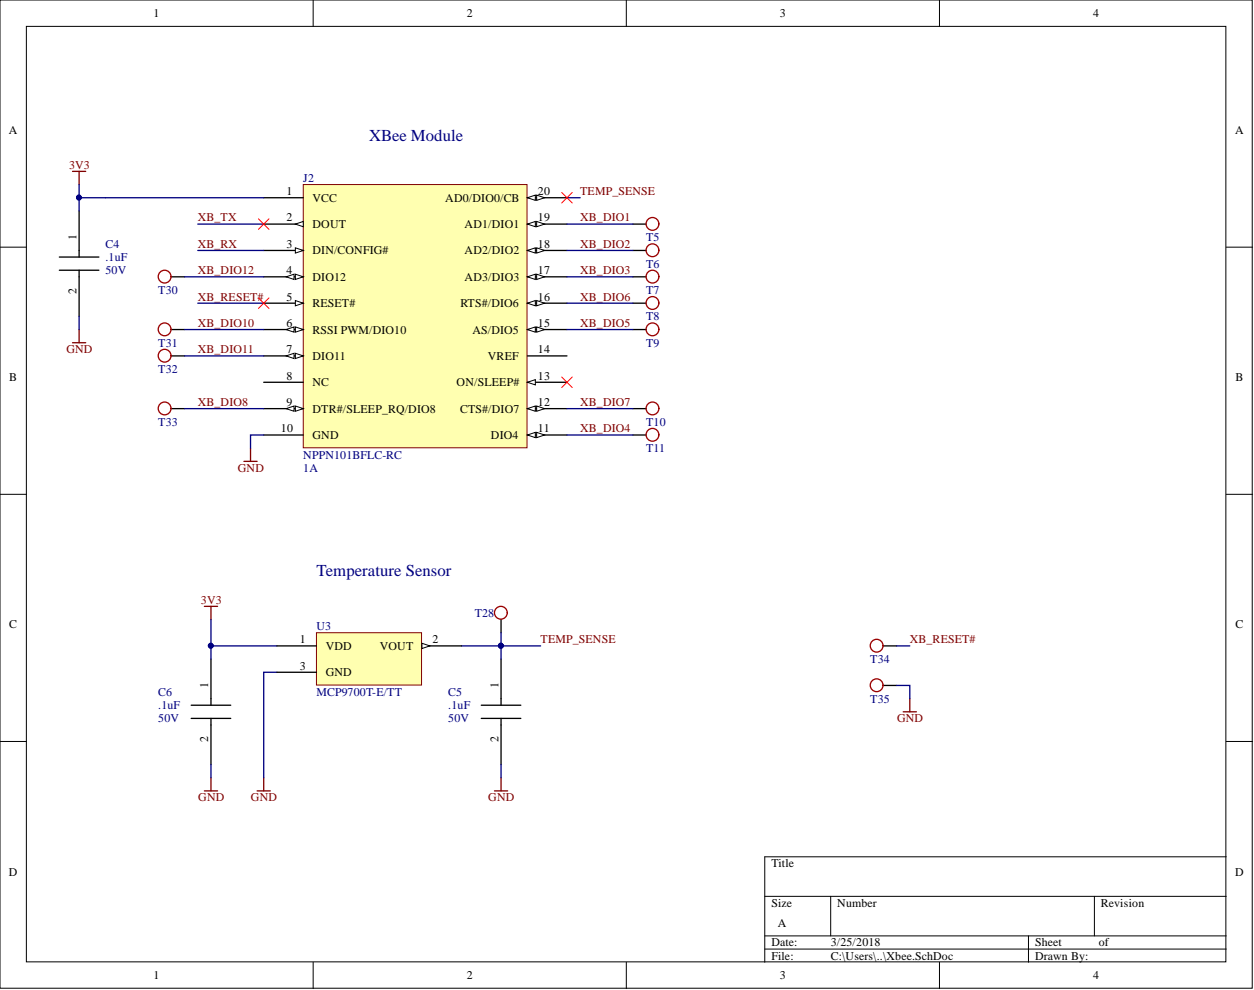
[picture p44: page 4]
