cb285/SeniorProject/hardware/electrical/Hub/Project Outputs for Hub/PCB 3D Print/PCB 3D Print Bottom.PDF

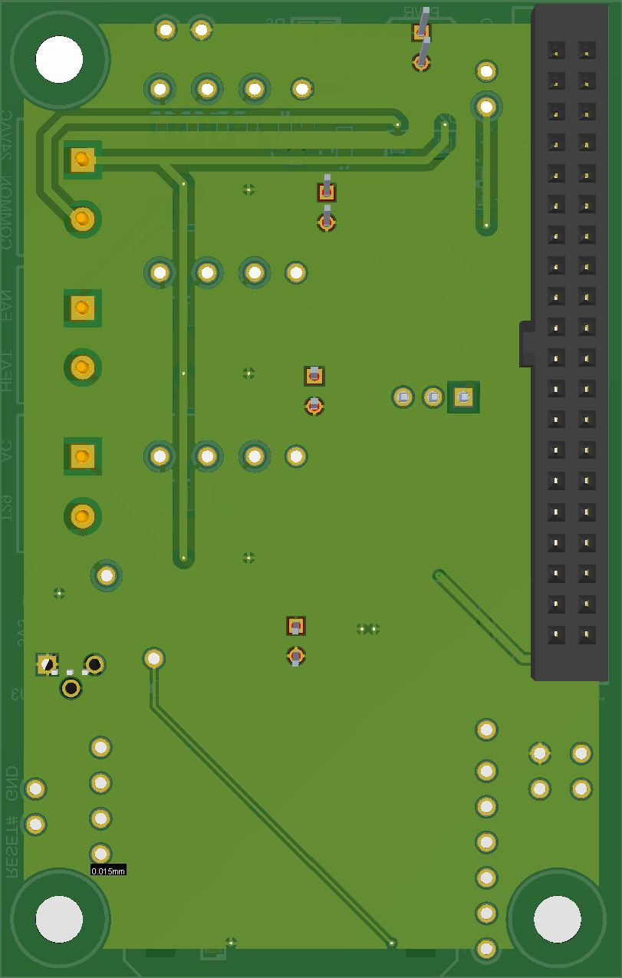
[picture p45: page 1]
