cb285/SeniorProject/hardware/electrical/Hub/Project Outputs for Hub/PCB 3D Print/PCB 3D Print Top.PDF

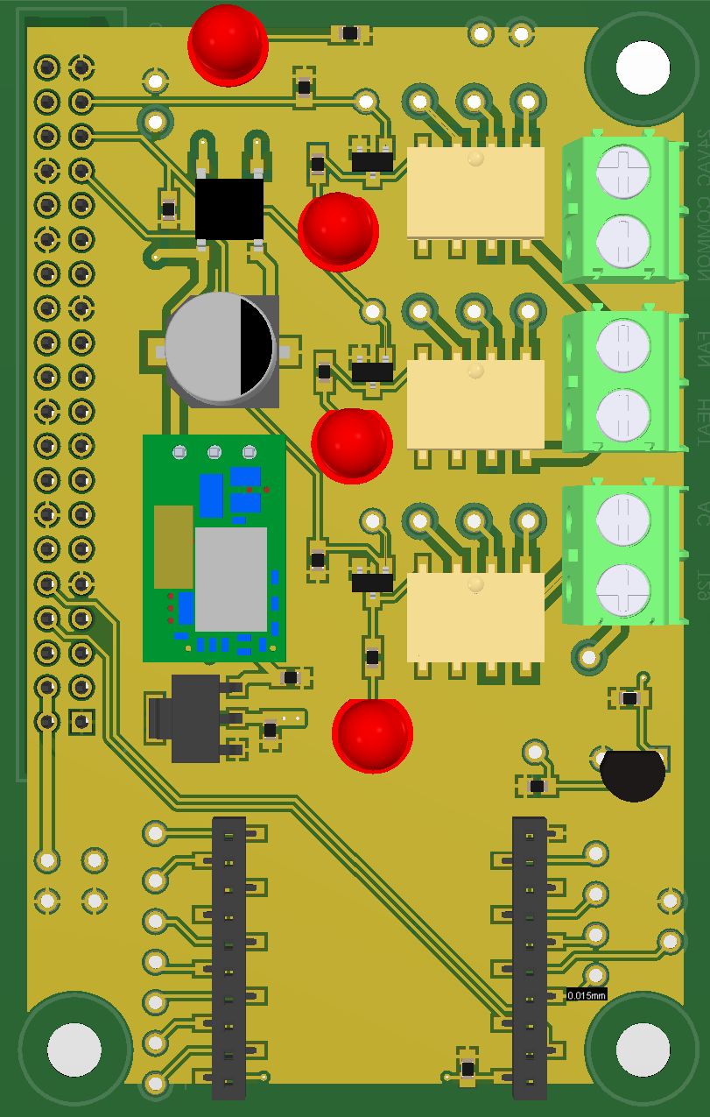
[picture p46: page 1]
