cb285/SeniorProject/hardware/electrical/Hub/Project Outputs for Hub/PCB Print/Composite Drawing.PDF

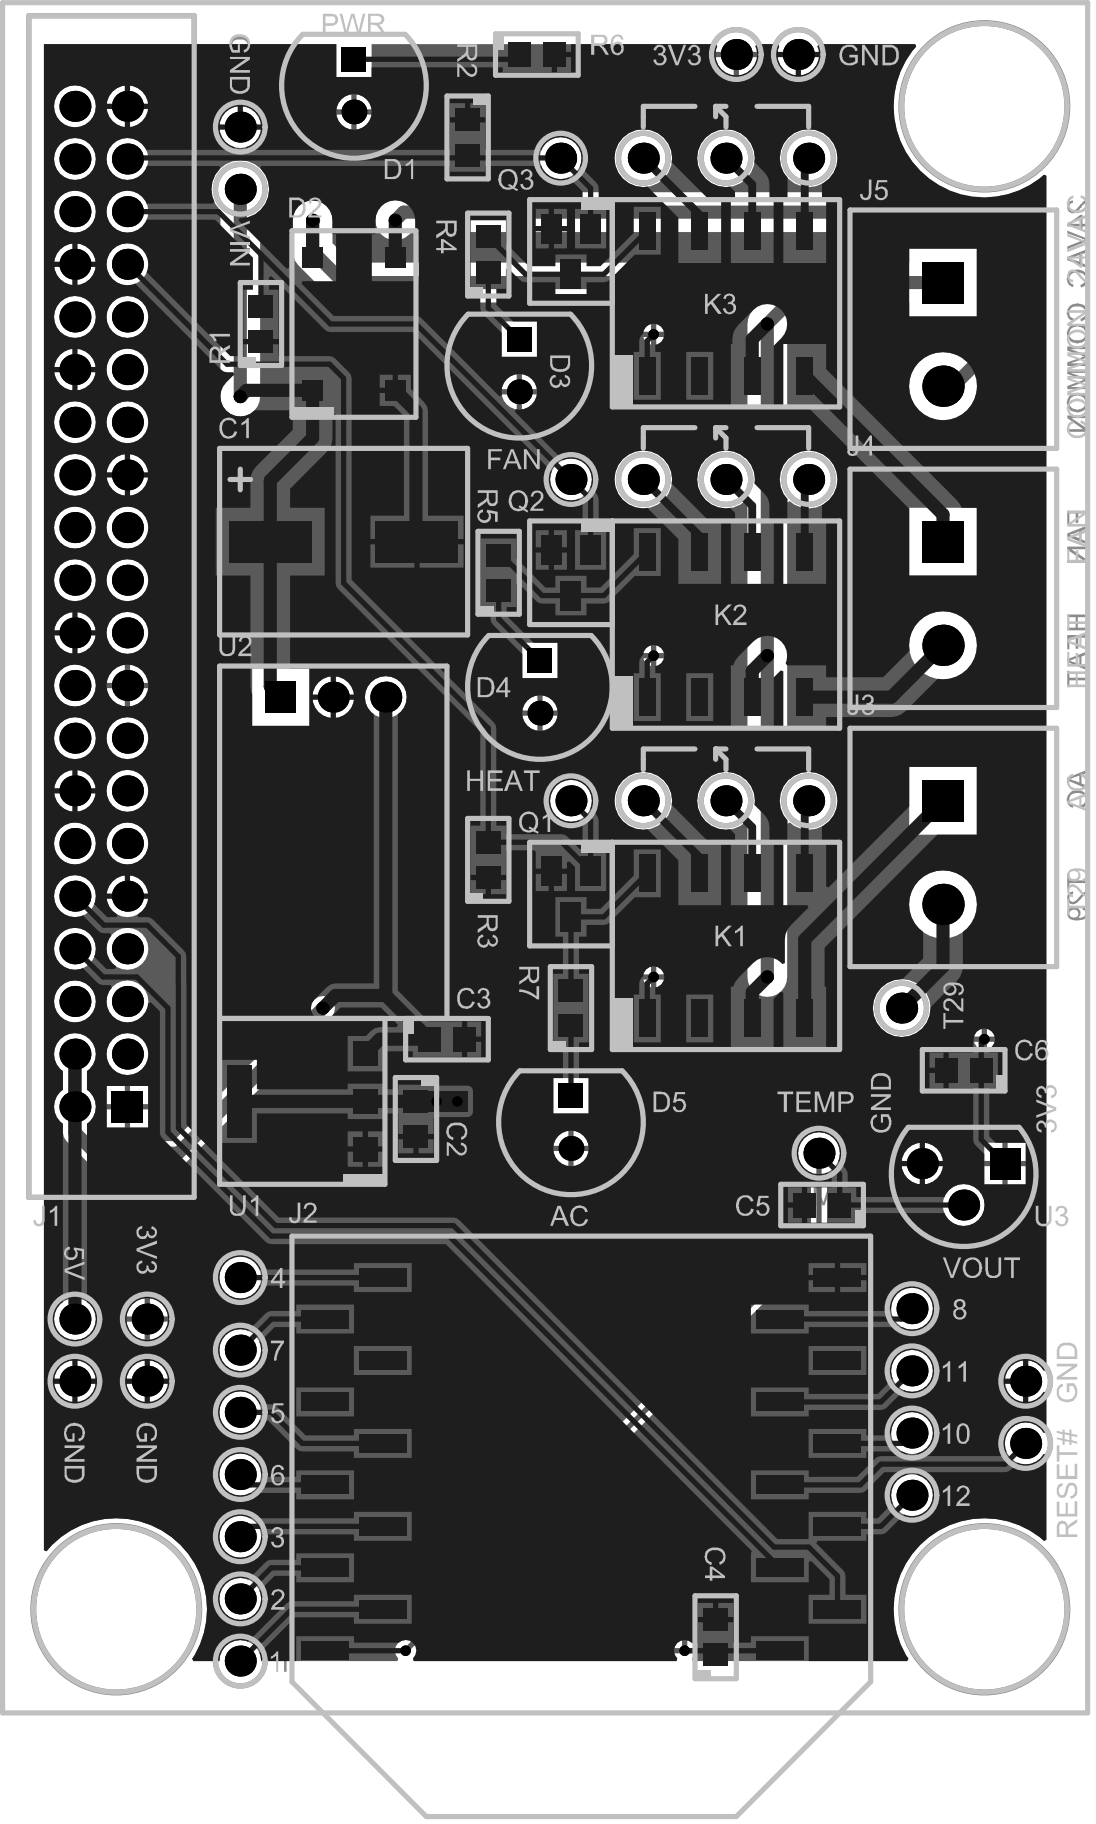
[picture p47: page 1]
