cb285/SeniorProject/hardware/electrical/PanelizedBoards/Project Outputs for PanelizedBoards/Drill Guide/Drill Guide.PDF

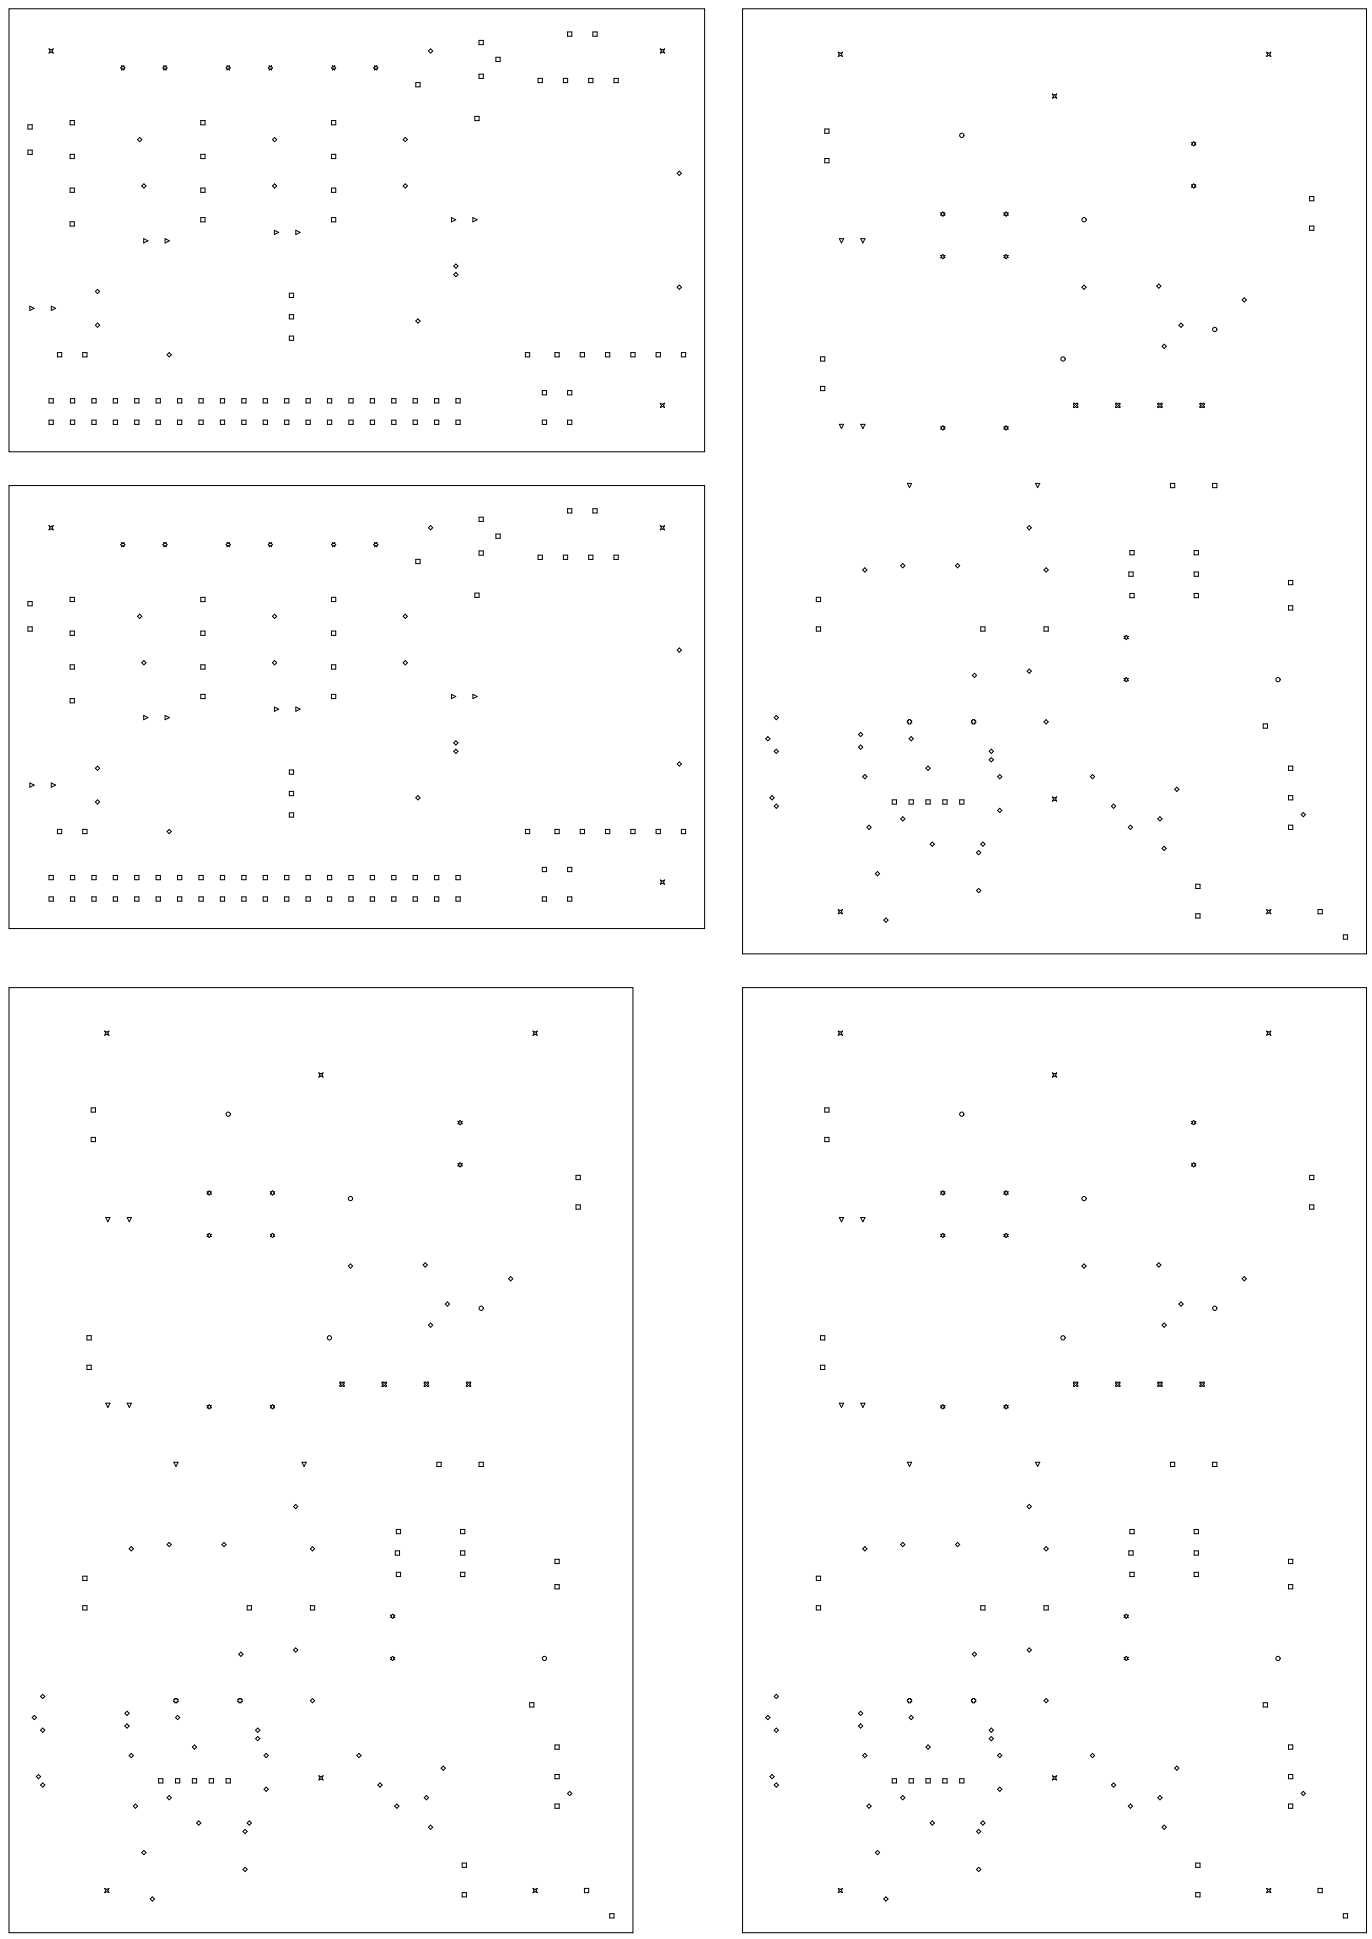
[picture p48: page 1]

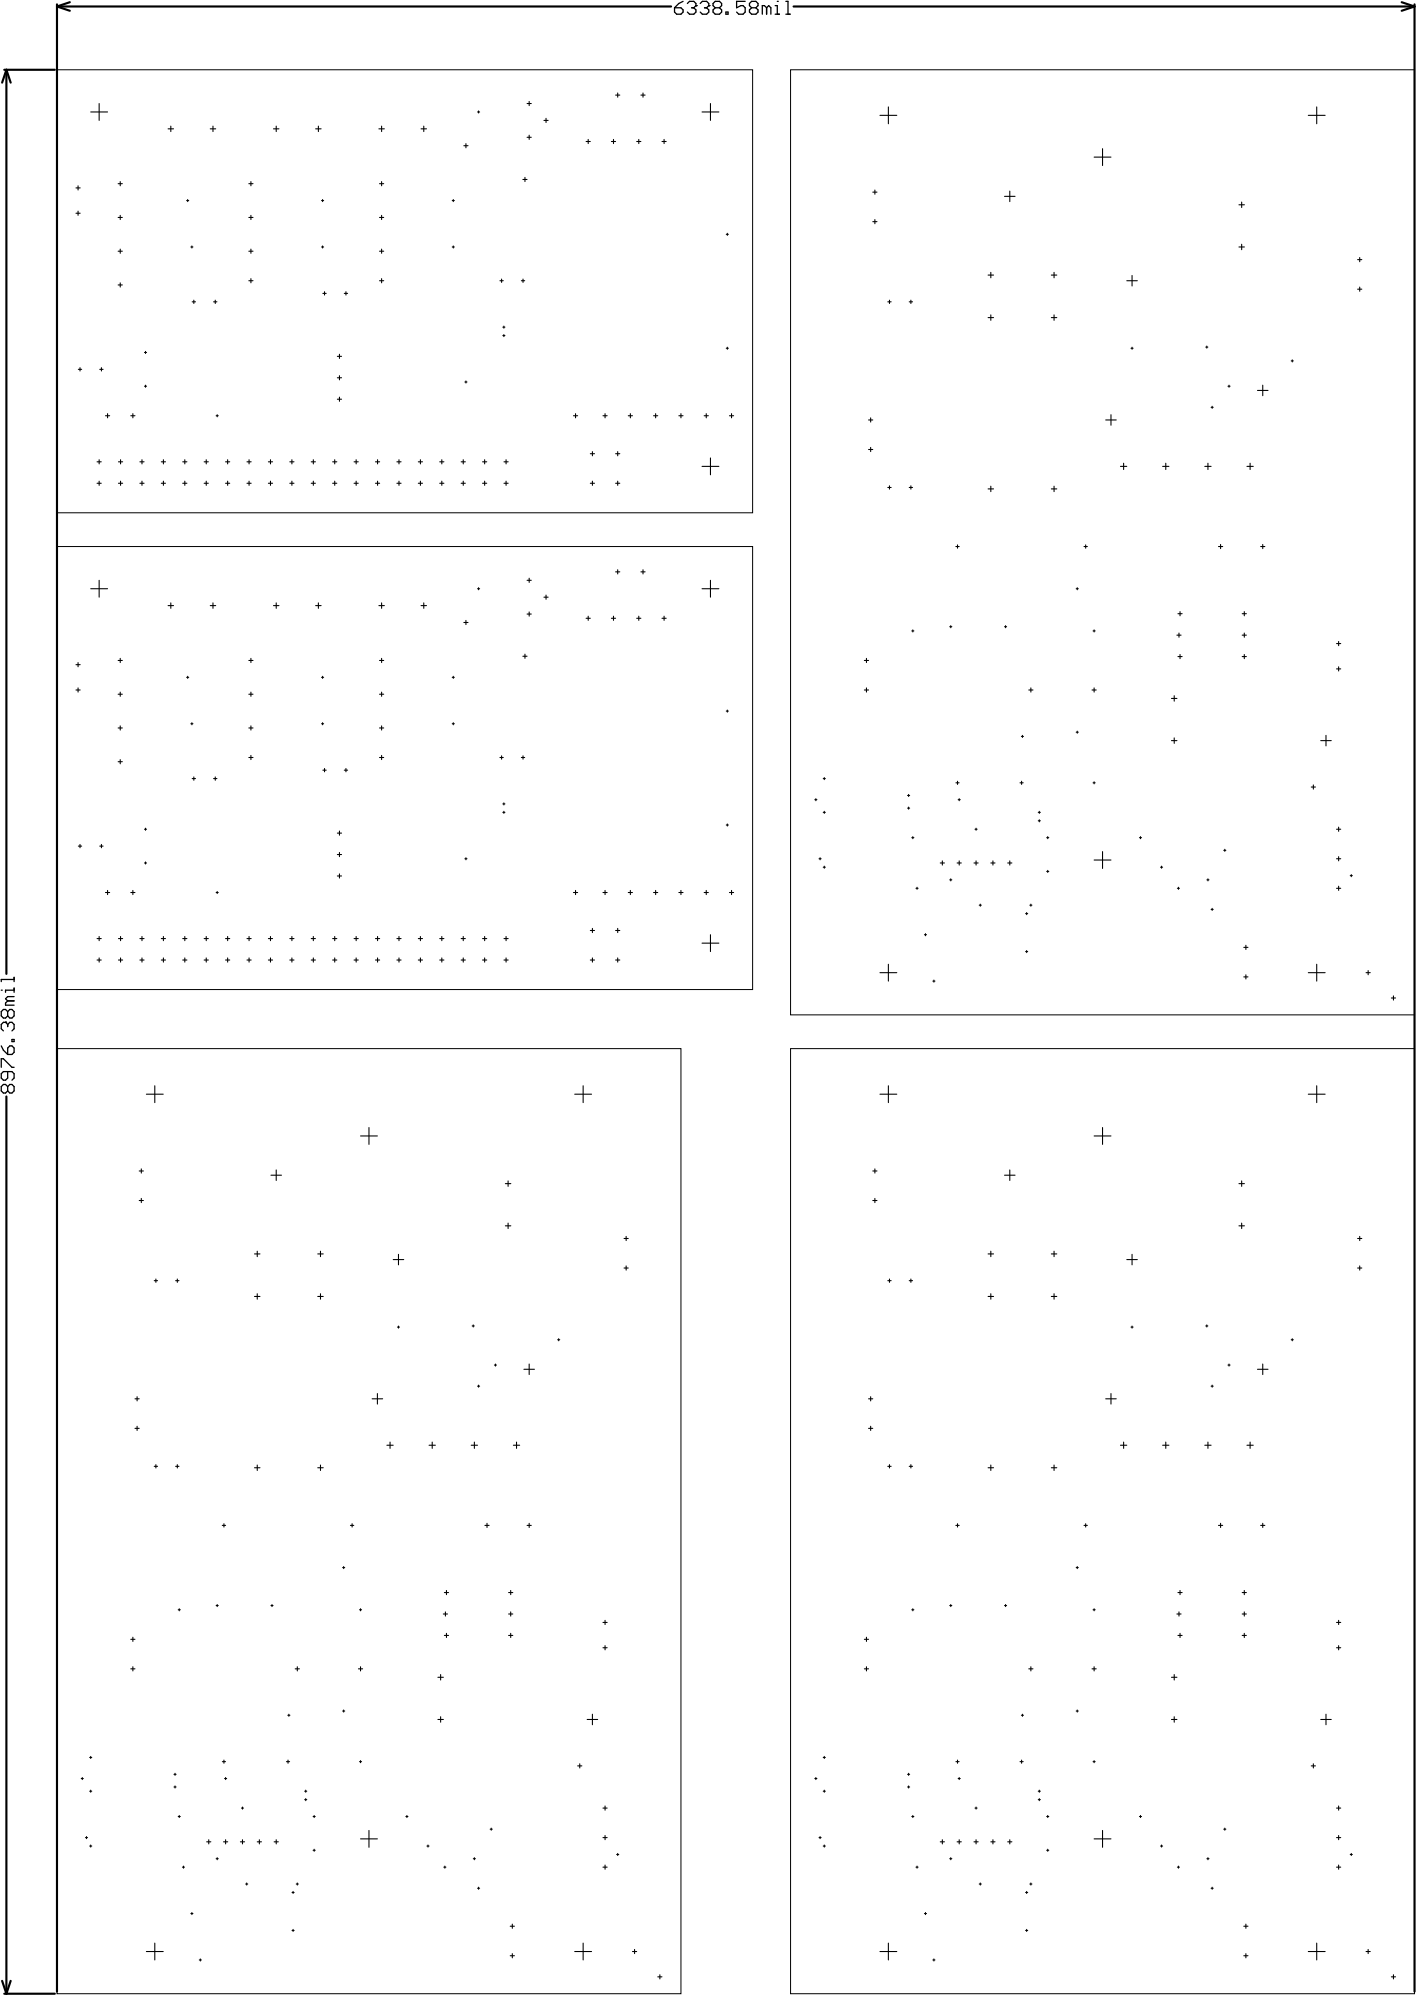
[picture p49: page 2]
