cb285/SeniorProject/hardware/electrical/LightSwitch/Project Outputs for SeniorProject/PCB Print/Composite Drawing.PDF

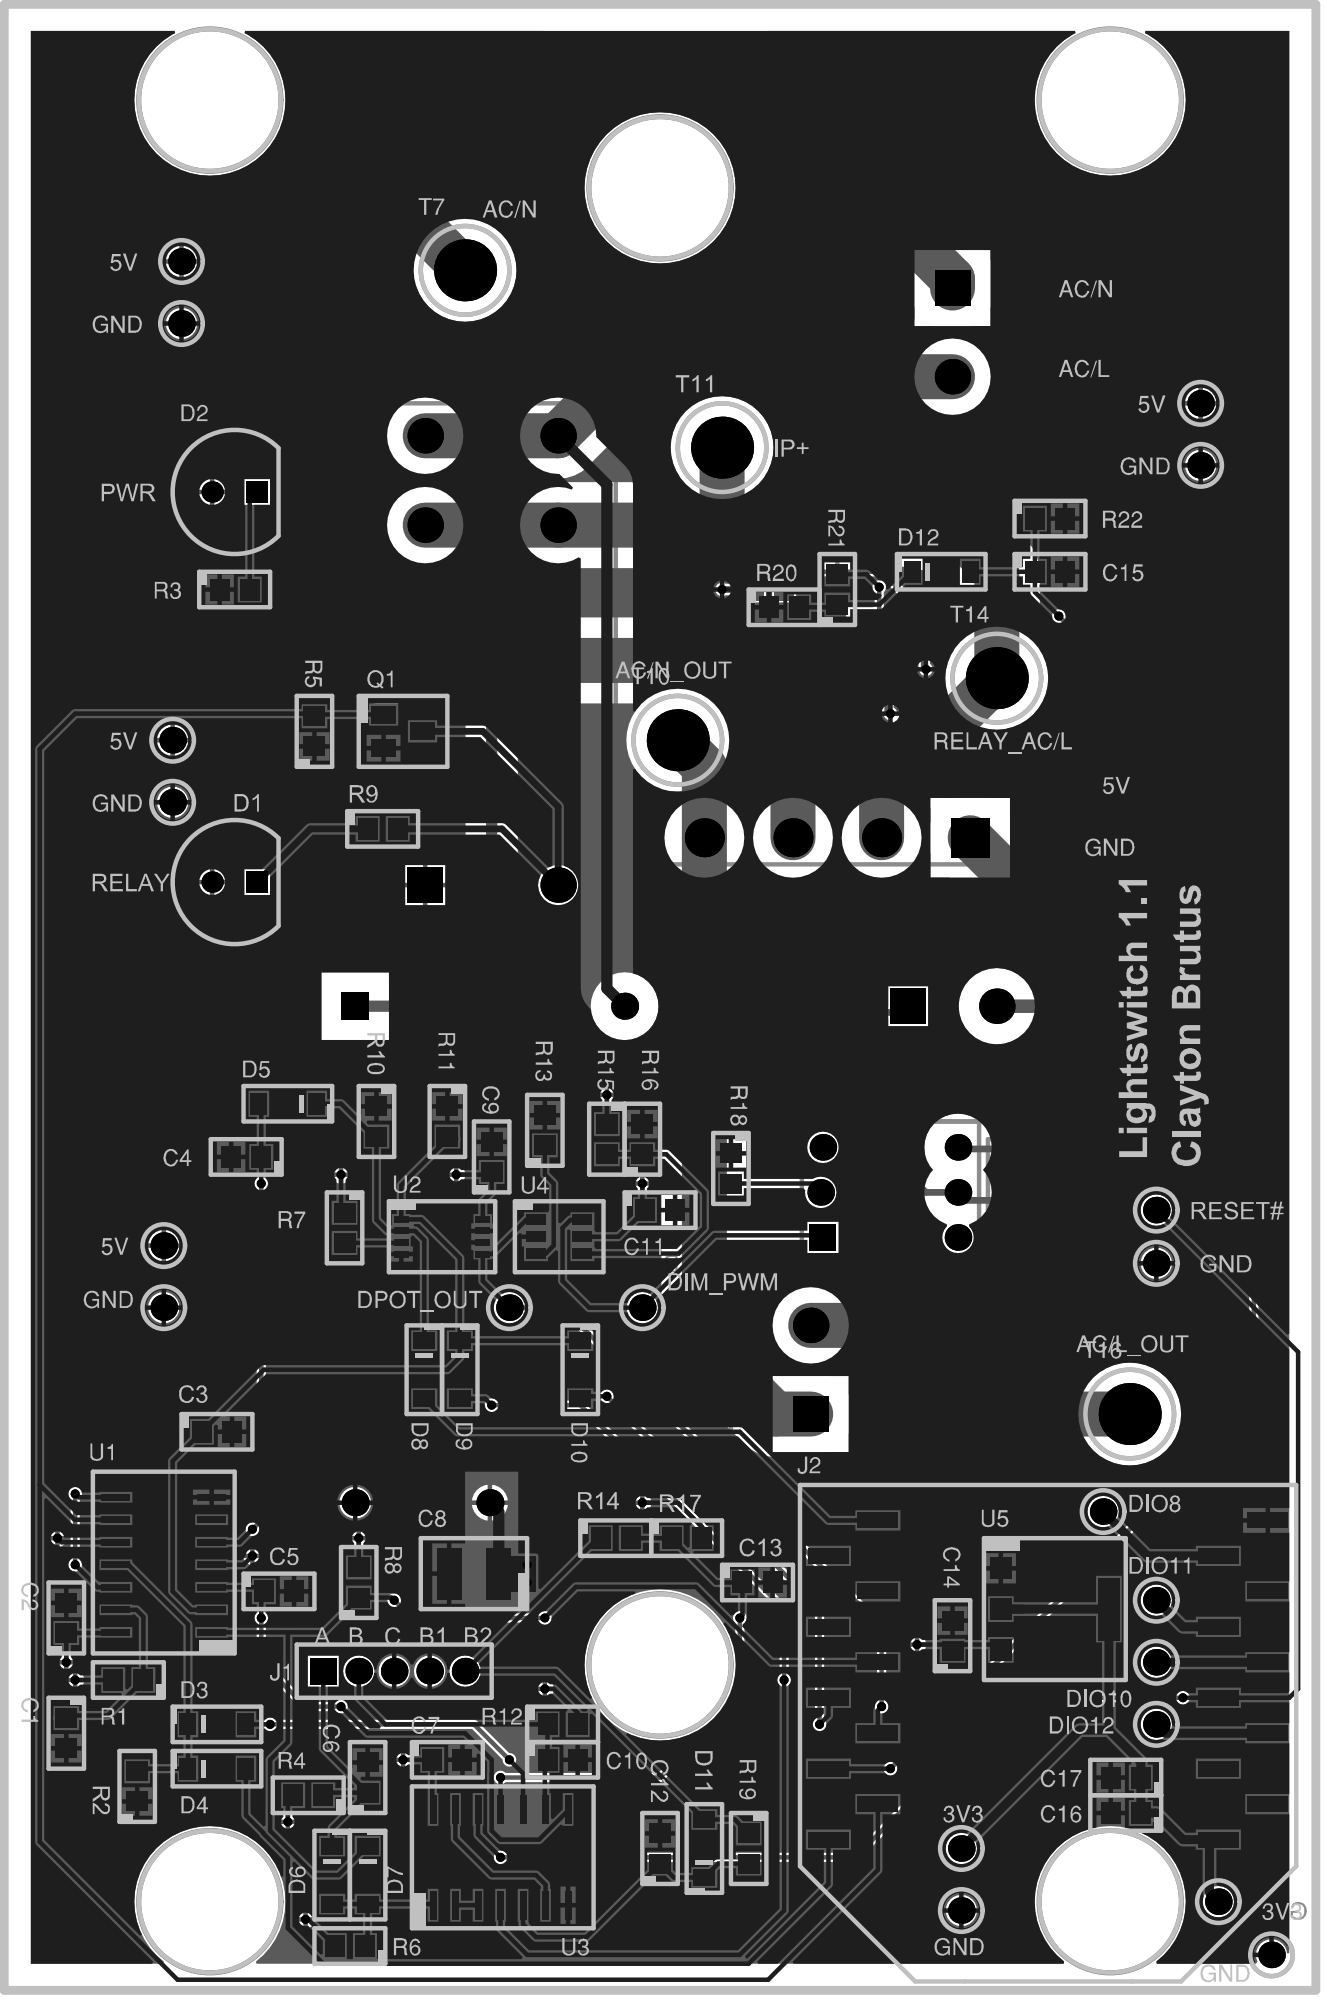
[picture p50: page 1]
