cb285/SeniorProject/hardware/electrical/LightSwitch/Project Outputs for SeniorProject/Schematic Print/Schematic Prints.PDF

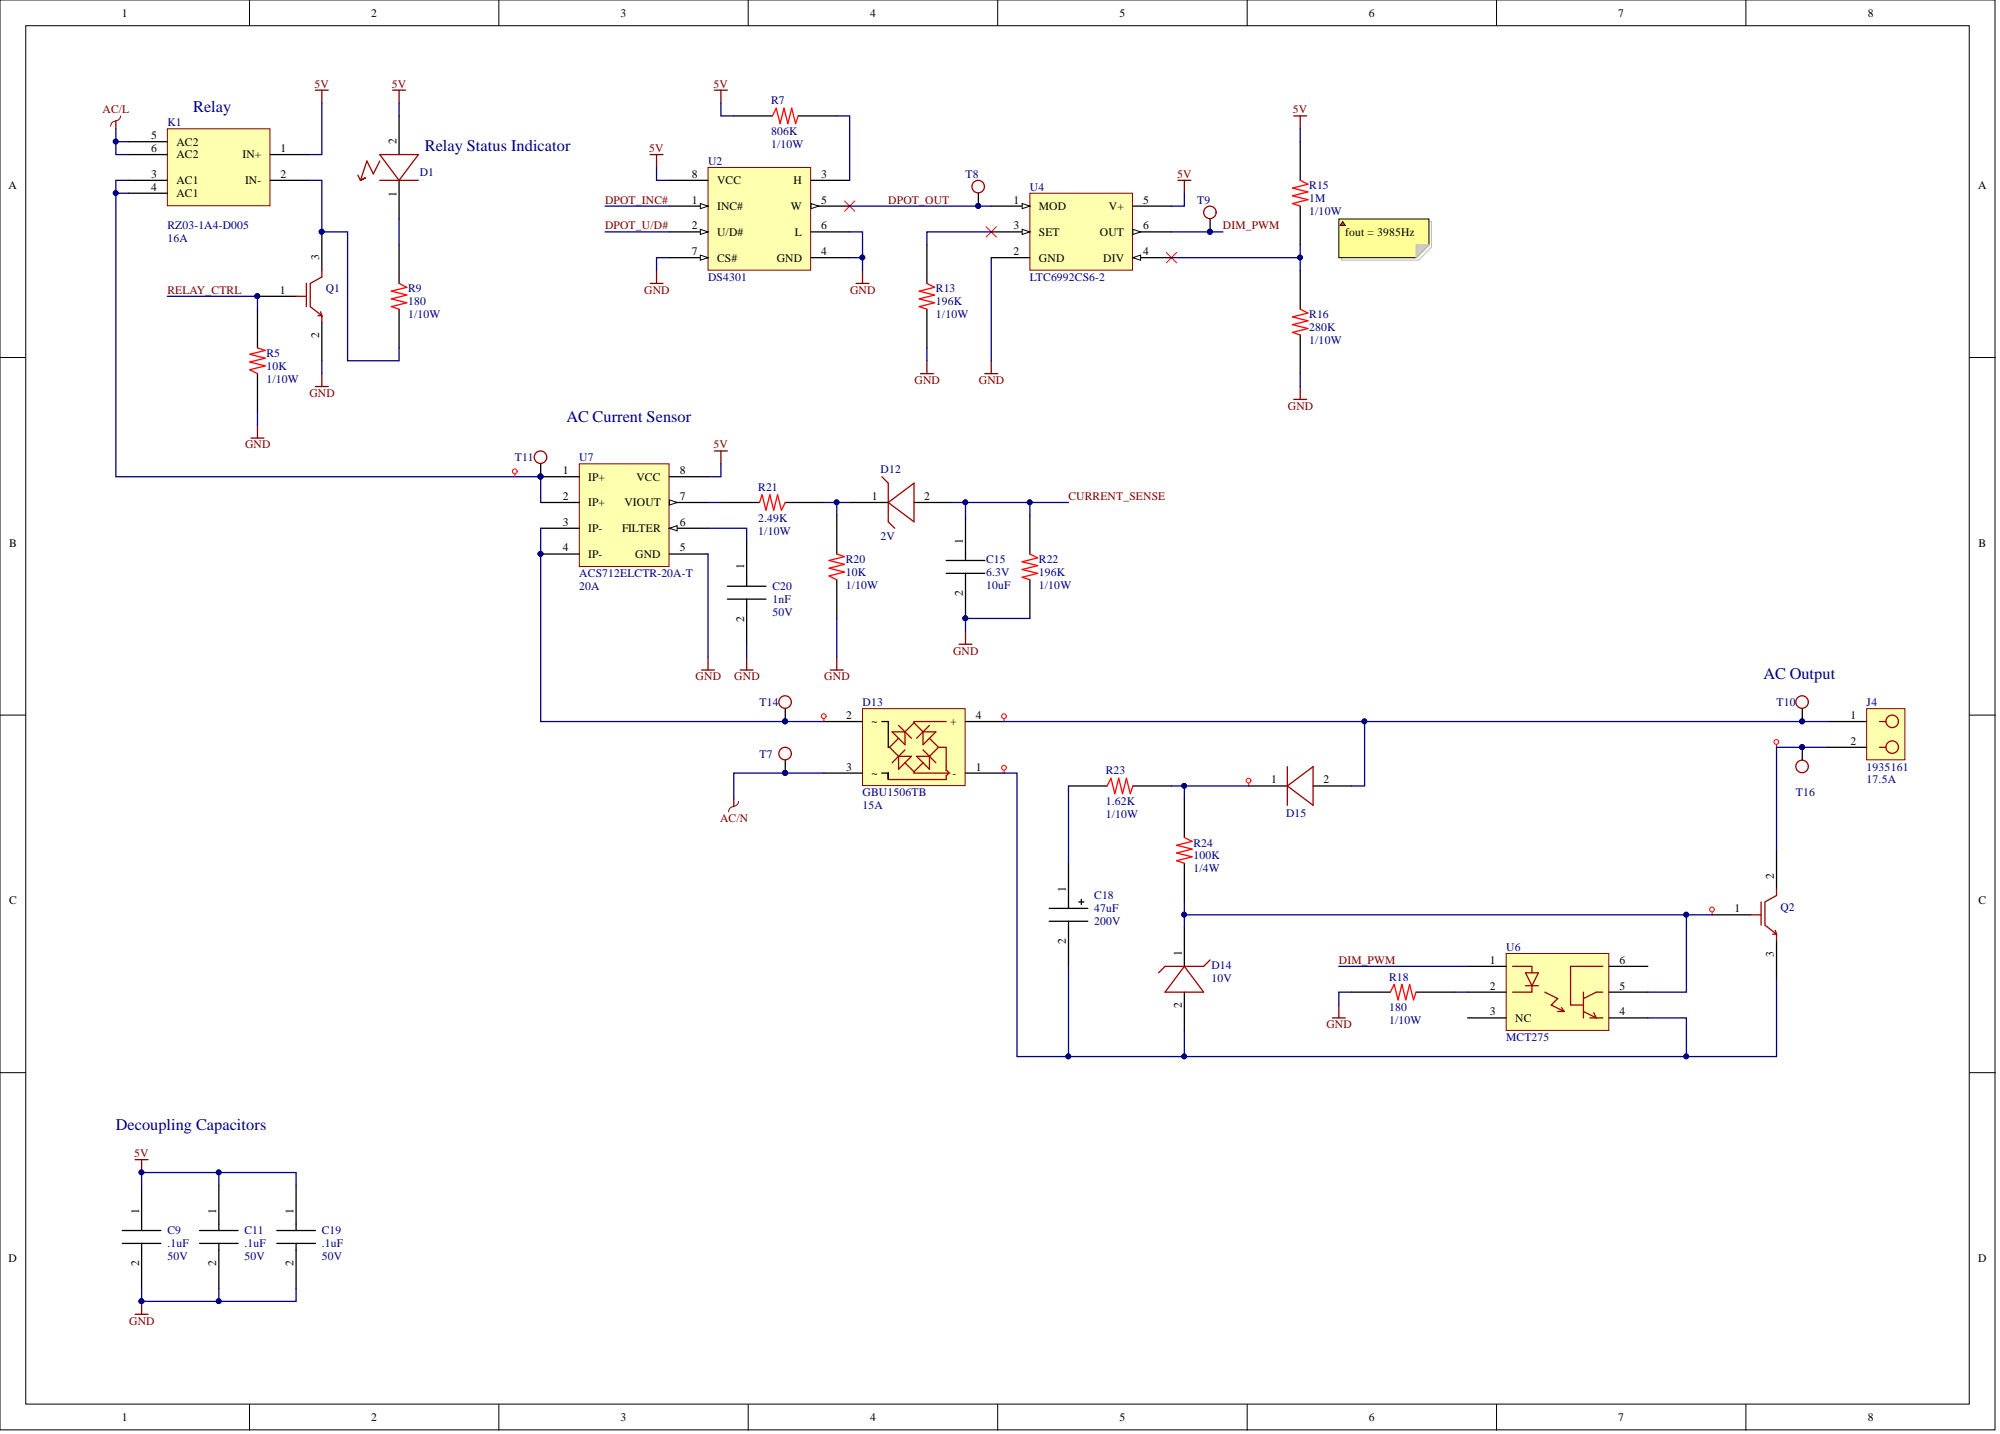
[picture p51: page 1]

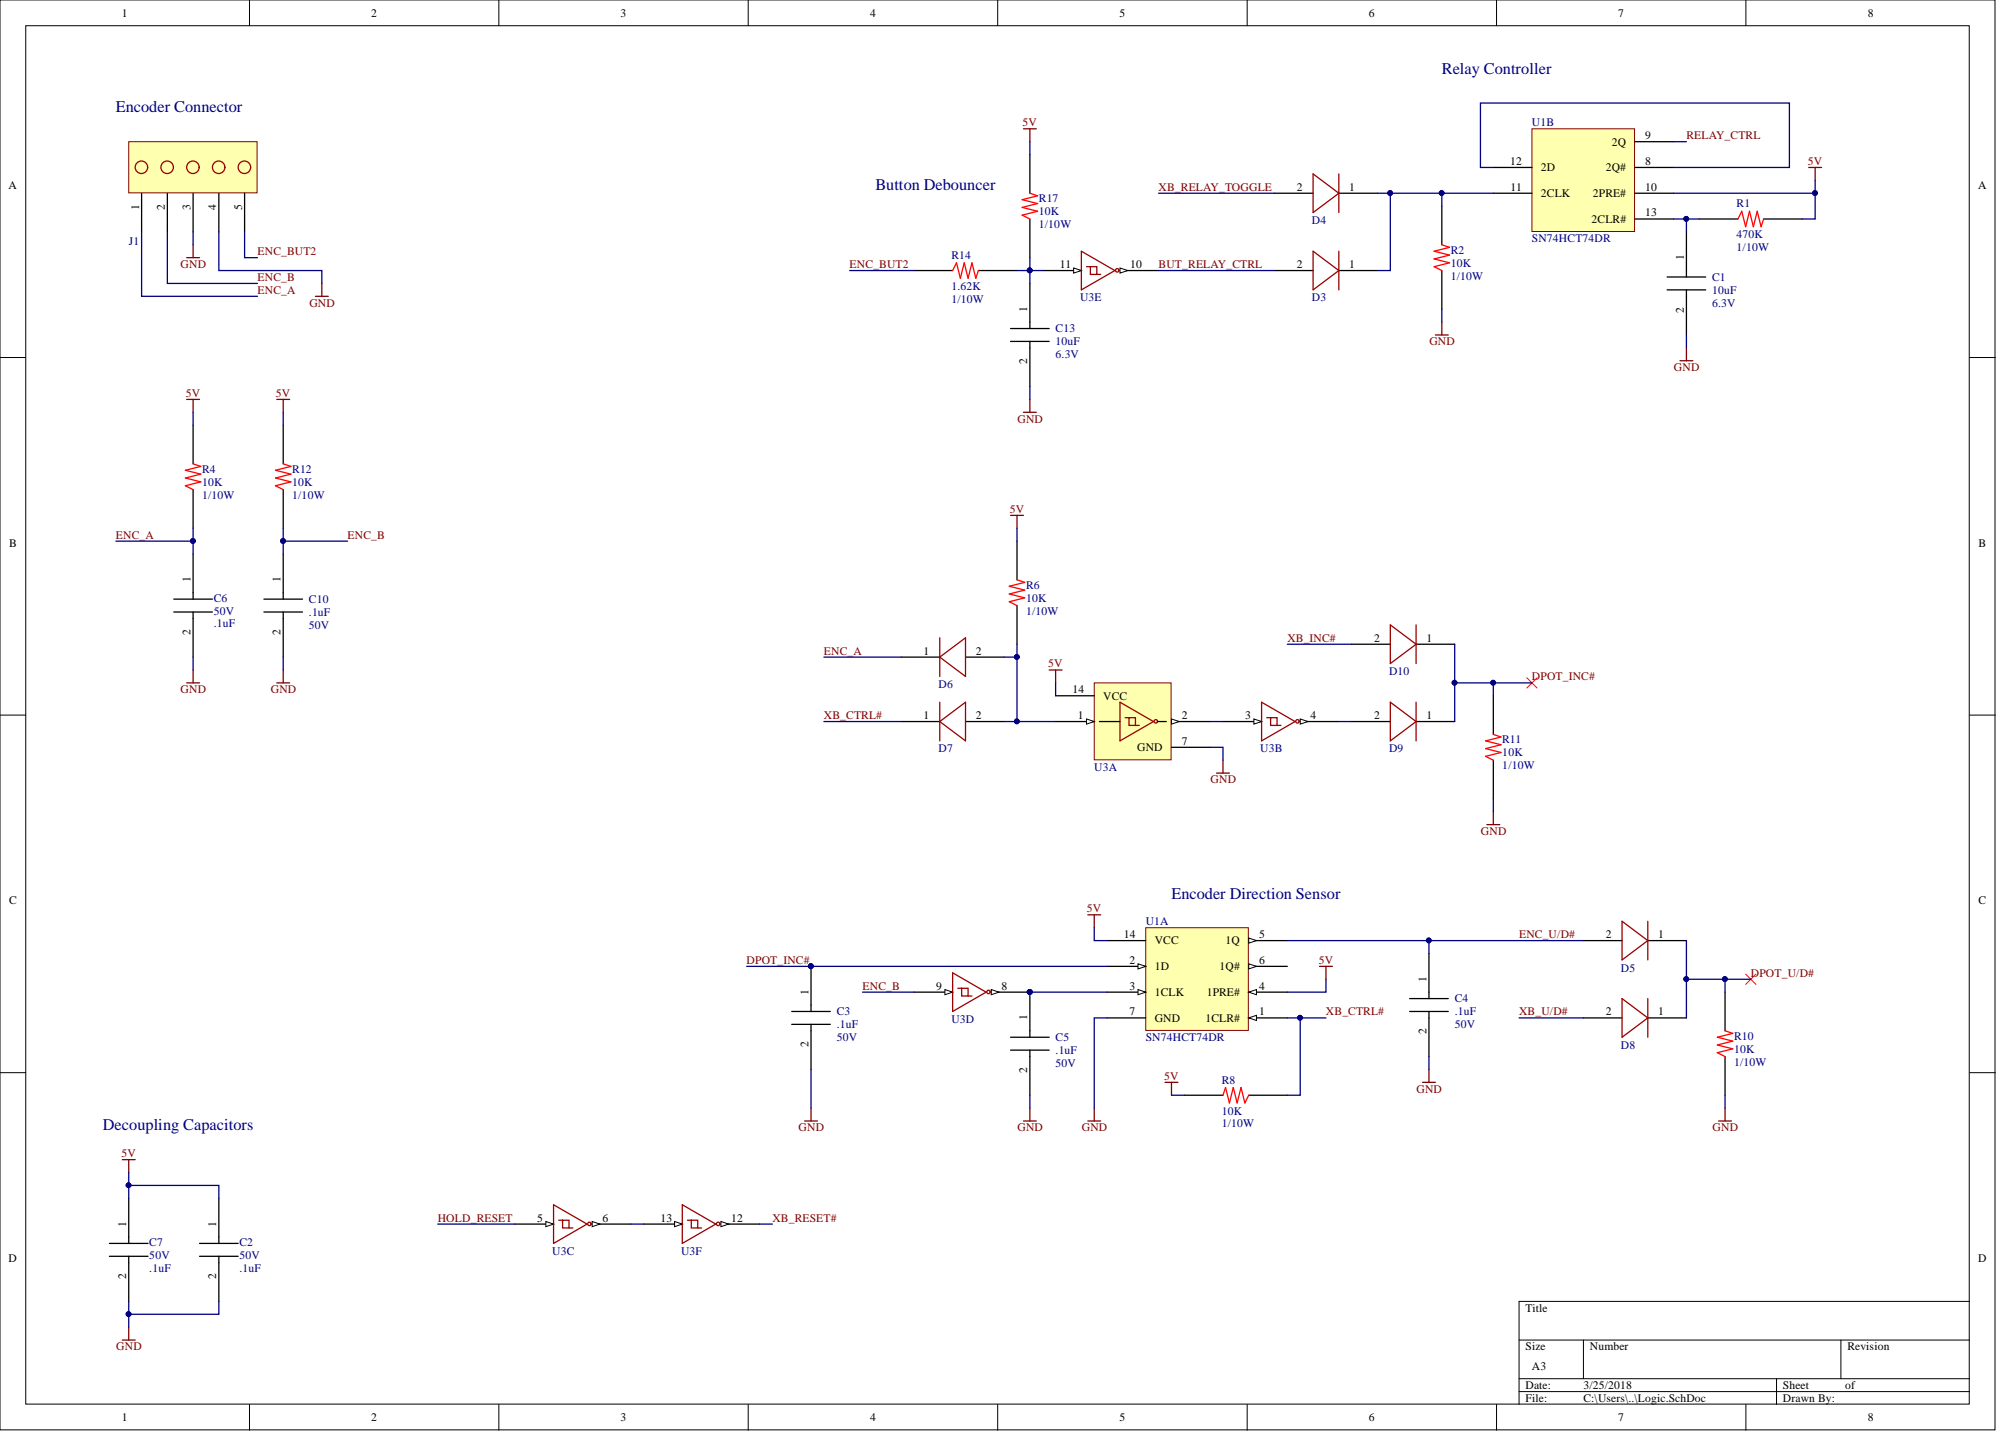
[picture p52: page 2]

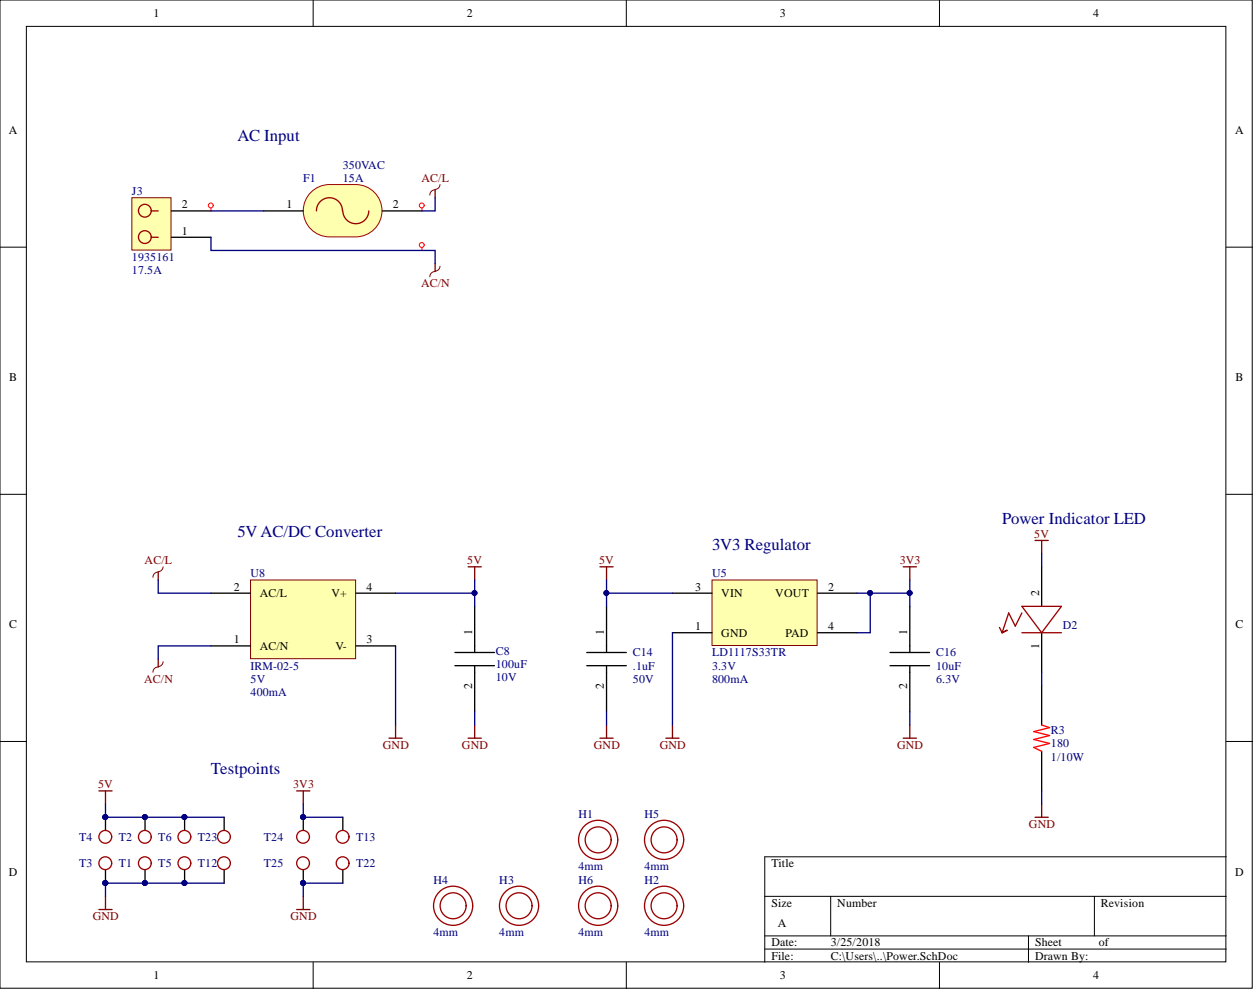
[picture p53: page 3]

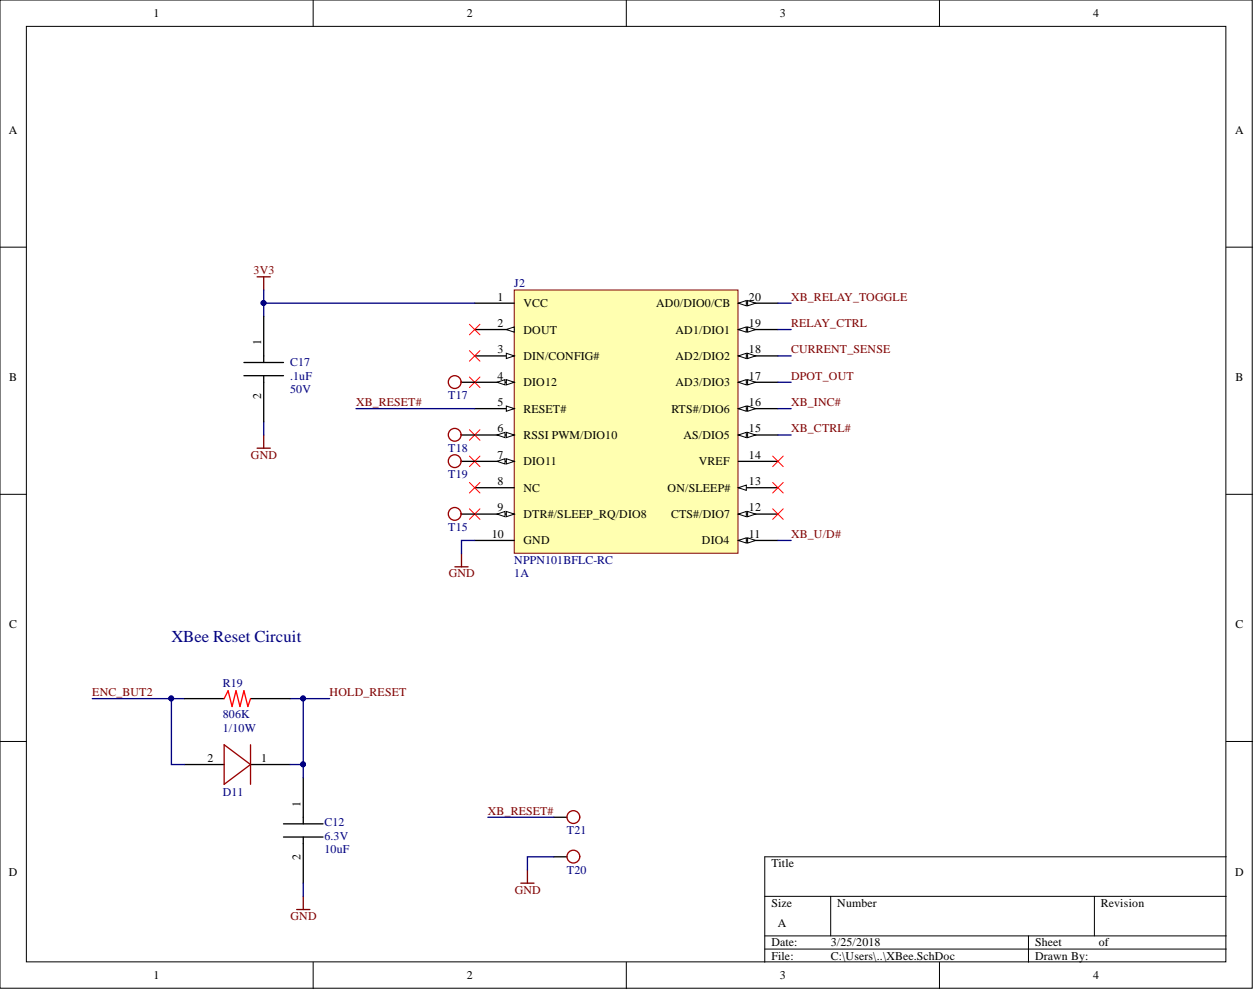
[picture p54: page 4]
