cb285/SeniorProject/hardware/electrical/LightSwitch/Project Outputs for SeniorProject/PCB 3D Print/PCB 3D Print Bottom.PDF

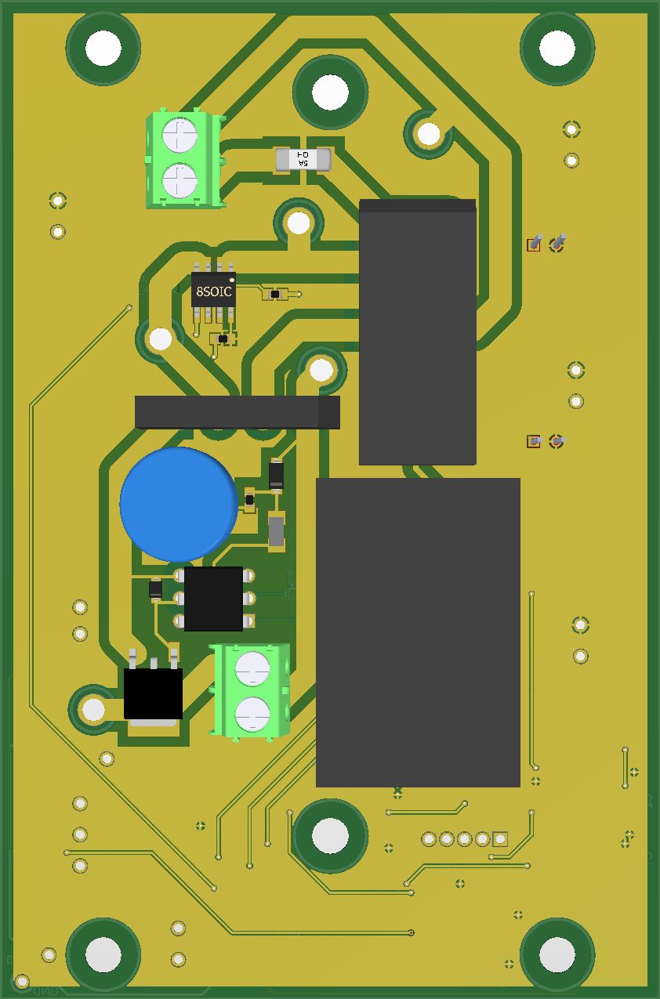
[picture p55: page 1]
