cb285/SeniorProject/hardware/electrical/LightSwitch/Project Outputs for SeniorProject/PCB 3D Print/PCB 3D Print Top.PDF

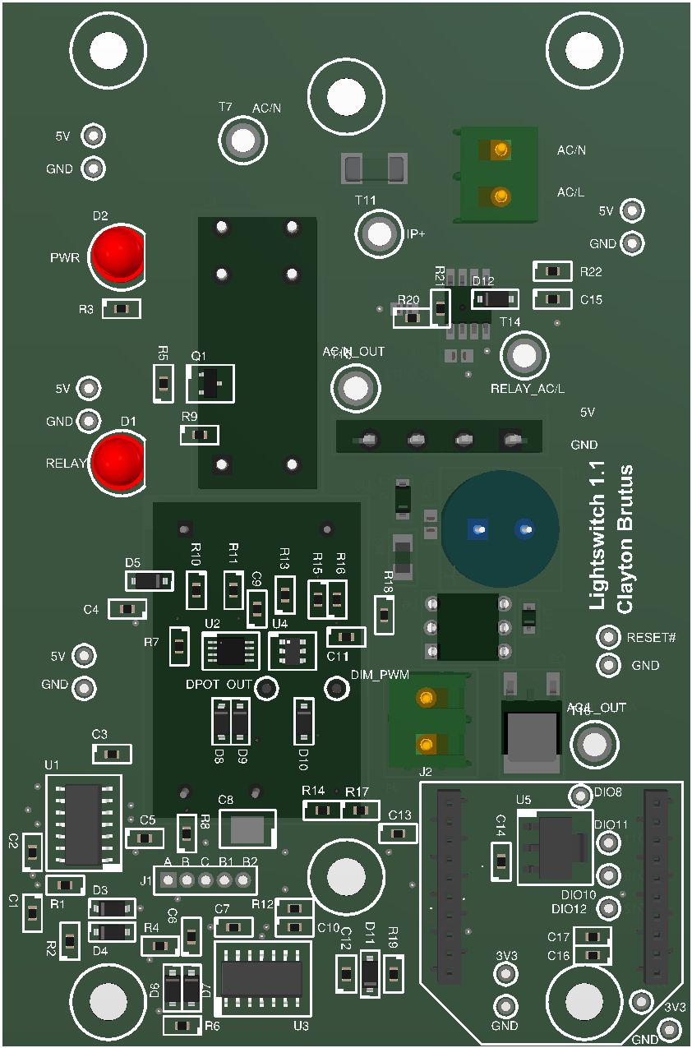
[picture p56: page 1]
