cb285/SeniorProject/(list of files, drawings)

Other design files:
hardware/electrical/EncoderDaughter/EncoderDaughter.PcbDoc
hardware/electrical/EncoderDaughter/EncoderDaughter.PrjPCB
hardware/electrical/EncoderDaughter/EncoderDaughter.SchDoc
hardware/electrical/Hub/Hub.PcbDoc
hardware/electrical/Hub/Hub.PcbLib
hardware/electrical/Hub/Hub.PrjPCB
hardware/electrical/Hub/Hub.SchLib
hardware/electrical/Hub/Sheets/Control.SchDoc
hardware/electrical/Hub/Sheets/Power.SchDoc
hardware/electrical/Hub/Sheets/Rpi.SchDoc
hardware/electrical/Hub/Sheets/Xbee.SchDoc
hardware/electrical/LightSwitch/LightSwitch.PcbDoc
hardware/electrical/LightSwitch/SeniorProject-Unused.PcbLib
hardware/electrical/LightSwitch/SeniorProject-Unused.SchLib
hardware/electrical/LightSwitch/SeniorProject.PcbLib
hardware/electrical/LightSwitch/SeniorProject.PrjPCB
hardware/electrical/LightSwitch/SeniorProject.SchLib
hardware/electrical/LightSwitch/Sheets/Dimmer.SchDoc
hardware/electrical/LightSwitch/Sheets/Logic.SchDoc
hardware/electrical/LightSwitch/Sheets/Power.SchDoc
hardware/electrical/LightSwitch/Sheets/XBee.SchDoc
hardware/electrical/PanelizedBoards/PanelizedBoards.PrjPCB
hardware/electrical/PanelizedBoards/PanellizedBoards.PcbDoc
hardware/electrical/SeniorProject.PrjPCB
