cb285/SeniorProject/(commit log)

2017-07-10 moved deviceMan.py to modules folder
2017-07-10 added init file for Modules directory, fixed deviceMan.py, started command line arg parsing
2017-07-25 created a DeviceManager class, added xbeeConnect
2017-07-26 removed modules folder and file (functions moved to homectrl_server.py) added socket server to homectrl_server.py and created homectrl_test_client.py for testing sending messages to it
2017-08-31 replaced sockets server interface with a http GET handler, added necessary imports
2017-12-20 switched to json db management, added comments, added log/return statements, added more request handling
2017-12-21 added current status to server db, wrote more descriptive responses/logs, stopped status updater on tile removal in gui
2018-01-18 fixed minor typos in code, init add of outlet pcb project
    [outletPCB.kicad_pcb, outletPCB.sch]
2018-01-23 changed testing device name, added script to start localtunnel, renamed systemd folder to scripts
2018-01-23 updated server url in gui, fixed device_db key errors, added print device_id for verifying
    [server_main.py]
2018-01-23 fixed device_db indexing, possibly fixed xbee addr storage/parsing
    [server_main.py]
2018-01-23 possibly fixed storing of ids in device_db
    [server_main.py]
2018-01-30 added XBee DIO constants, fixed id2xbee
    [server_main.py]
2018-01-30 fixed typo in id2xbee, changed baudrate to 9600, cleaned up serial connection function
    [server_main.py]
2018-01-30 fixed xbeeConnect typo in main, updated subdomain on localtunnel service
    [server_main.py]
2018-01-30 changed serial port to correct one, lowered timeout
    [server_main.py]
2018-01-31 changed device_db structure to dict of dicts, added input handler for toggle button presses, added lock (not currently working)
2018-02-03 fixed syntax errors and indentations
    [home.py]
2018-02-08 fixed forced sampling with workaround, added periodic device discovery
    [home.py]
2018-02-13 init commit of altium project
    [SeniorProject.PcbLib, SeniorProject.PrjPCB, SeniorProject.SchLib, outletPCB.kicad_pcb, outletPCB.sch]
2018-02-13 init commmit of Power.SchDoc
    [Power.SchDoc]
2018-02-13 added components to libs, added Power.SchDoc
    [Dimmer.SchDoc, Power.SchDoc, SeniorProject.PcbLib, SeniorProject.PrjPCB, SeniorProject.SchLib]
2018-02-13 added XBee.SchDoc, added XBee component
    [Power.SchDoc, SeniorProject.PcbLib, SeniorProject.PrjPCB, SeniorProject.SchLib, XBee.SchDoc]
2018-02-14 added components to libs and sheets
    [Dimmer.SchDoc, Power.SchDoc, SeniorProject.PcbLib, SeniorProject.SchLib, XBee.SchDoc]
2018-02-15 created board outline, added components to libs
    [Dimmer.SchDoc, LightSwitch.PcbDoc, Power.SchDoc, SeniorProject.PcbLib, SeniorProject.PrjPCB, SeniorProject.SchLib, XBee.SchDoc]
2018-02-16 added components to libs, connecting main components in sheets
    [Dimmer.SchDoc, LightSwitch.PcbDoc, Power.SchDoc, SeniorProject.PcbLib, SeniorProject.SchLib, XBee.SchDoc]
2018-02-16 init commit of mechanical part and assy
    [LightSwitchAssembly.iam, LightSwitchCover.ipt]
2018-02-16 added encoder part, adjusted thickness of cover to .1", added fillets to outside edges
    [LightSwitchAssembly.iam, LightSwitchCover.ipt, PEC11-4215F-S24.ipt, PEC11-4215F-S24.stp]
2018-02-16 moved altium files to electrical folder
    [Dimmer.SchDoc, LightSwitch.PcbDoc, Power.SchDoc, SeniorProject.PcbLib, SeniorProject.PrjPCB, SeniorProject.SchLib, XBee.SchDoc]
2018-02-21 added Logic Sheet, added components to libs, switched caps/resistors to 0603's where possible
    [Dimmer.SchDoc, LightSwitch.PcbDoc, Logic.SchDoc, Power.SchDoc, SeniorProject.PcbLib, SeniorProject.PrjPCB, SeniorProject.SchLib, XBee.SchDoc]
2018-02-21 added 3d models of some components, added components to libs, replaced 100uF 200V cap with 47uF 200V cap, started connecting some xbee pins
    [CAP12.5X20.ipt, CAP12.5X20.stp, DIP16-4.ipt, DIP16-4.stp, Dimmer.SchDoc, Logic.SchDoc, Power.SchDoc, RES0603.STEP]
2018-02-21 started adding support for dimming light device-type, removed old server_main
2018-02-22 fixed RELAY_CTLR nameerror
2018-02-22 (hopefully) finished fixing exception catching
    [home.py]
2018-02-22 fixed variable name in server_main, changed DIO constants to 2 bytes
    [home.py, server_main.py]
2018-02-22 fixed typo in change_name command
    [home.py]
2018-02-22 fixed variable name in Change_device_name
    [home.py]
2018-02-22 set DFLIP_CLR_N to high (not cleared) when adding light device
2018-02-22 changed force sample pins to D6,D7
2018-02-23 tried to fix constant force sampling problem
    [home.py]
2018-02-23 added adc to change detection mask
2018-02-23 fixed acd packet sample key
    [home.py]
2018-02-23 fixed recv handler adc sample handling
    [home.py]
2018-02-23 fixed pin constants, removed extra plus in log string
    [home.py]
2018-02-23 remove force sample from get_device_level when it is unknown
2018-02-23 added set U/D# to low when adding light device
2018-02-23 fixed INC being left high
    [home.py]
2018-02-26 fixed light device pin states in add_device, changed node identifier divider to '-', inverted DPOT voltage to level conversion (now: low voltage => higher level)
    [home.py]
2018-02-26 fixed DFLIP CS# pin state
    [home.py]
2018-02-27 fixed set_device_level for decrementing
    [home.py]
2018-02-27 in set_device_level: fixed indentation mistake, added waits to help ensure package delivery order is correct
    [home.py]
2018-02-28 fixed recv_handler not releasing process_packets lock
    [home.py]
2018-02-28 started adding new components to libs, replacing in sheets
    [0603.STEP, Dimmer.SchDoc, GBU.STEP, Logic.SchDoc, Power.SchDoc, SOD123.stp, SOD323.stp, SOIC14.stp]
2018-03-01 added new components to libs, fixed parameters in sch lib
    [AC1015.ipt, AC1015.stp, Dimmer.SchDoc, IRM-02-5.ipt, IRM-02-5.stp, Logic.SchDoc, NPPN101BFLC-RC.STEP, Power.SchDoc]
2018-03-02 added and swapped components, initial try for PCB
    [0679H.stp, Dimmer.SchDoc, LightSwitch.PcbDoc, Logic.SchDoc, Power.SchDoc, SeniorProject.PcbLib, SeniorProject.PrjPCB, SeniorProject.SchLib]
2018-03-03 created daughterboard, rerouted pcb, added testpoints, added power led, added panelized board
    [0603.STEP, 0679H.stp, 1GangSwitchBox.STEP, AC1015.ipt, AC1015.stp, CAP12.5X20.ipt, CAP12.5X20.stp, DIP16-4.ipt]
2018-03-12 fixed light dimming direction
    [home.py]
2018-03-12 checked/fixed components, added relay indicator LED, added reset circuit, moved unused components to separate libraries
    [Dimmer.SchDoc, LightSwitch.PcbDoc, Logic.SchDoc, Power.SchDoc, SeniorProject-Unused.PcbLib, SeniorProject-Unused.SchLib, SeniorProject.PcbLib, SeniorProject.PrjPCB]
2018-03-13 fixed small schematic issues, fixed AC clearance, routed modified parts
    [Dimmer.SchDoc, LightSwitch.PcbDoc, Logic.SchDoc, Power.SchDoc, XBee.SchDoc]
2018-03-13 lightswitch 1.0 release
    [Dimmer.SchDoc, LightSwitch.PcbDoc, SeniorProject.PrjPCB]
2018-03-13 added 1.0 release BOM
    [Lightswitch 1.0 BOM.xlsx]
2018-03-14 added prices
    [Lightswitch 1.0 BOM.xlsx]
2018-03-16 adjusted lightswitch cover size and shape, created STL to print
    [1GangSwitchBox.ipt, EncoderDaughter.step, LightSwitchCover 1.0.stl, LightSwitchCover.ipt, PEC11-4215F-S24.ipt]
2018-03-16 added power monitoring capabilities (commented out)
2018-03-16 made light level round up to 100 for >=95, fixed syntax error
    [home.py]
2018-03-16 fixed Empty exception handling when queue get timed out, reduced DEFAULT_TIMEOUT to 2 seconds for alexa to respond properly (alexa timeout is 3 seconds)
    [home.py]
2018-03-17 fixed logging to journald, updated log file path
    [home.py]
2018-03-17 removed printing log entries
2018-03-17 updated database and power usage file names
2018-03-17 fixed tasks db file path
    [home.py]
2018-03-17 init commit of Hub PCB Project
    [Hub.PcbDoc, Hub.PcbLib, Hub.PrjPCB, Hub.SchDoc, Hub.SchLib]
2018-03-17 fixed rpi header outline
    [Hub.PcbLib, Hub.SchLib]
2018-03-17 added components from other project libs, re-arranged schematic sheets
    [CAP10X20.step, Control.SchDoc, Hub.PcbLib, Hub.SchDoc, Hub.SchLib, Power.SchDoc, Rpi.SchDoc, SIOC8.stp]
2018-03-19 added functions for thermostat server requests, added actual thermostat functionality, added refresh button
2018-03-19 started adding device adding functionality, changed server requests functions to handle errors better
2018-03-21 added/replaced components, started routing pcb
    [ABS.step, Control.SchDoc, DO15.STEP, EEE-1HA101UP.STEP, G6K_2F.step, Hub.PcbDoc, Hub.PcbLib, Hub.PrjPCB]
2018-03-21 finished routing
    [Control.SchDoc, Hub.PcbDoc, Hub.PrjPCB, Power.SchDoc, Rpi.SchDoc, Xbee.SchDoc]
2018-03-21 checked parts, added power indicator LED, added outjob
    [Control.SchDoc, Hub.PcbDoc, Hub.PcbLib, Hub.PrjPCB, Power.SchDoc, Rpi.SchDoc]
2018-03-21 fixed thermostat task, updated thermostat control pins
    [home.py]
2018-03-21 changed sampling scheme to allow local xbee samples, added temp measurement adc pin setup
2018-03-22 added pull down resistors to relay control signals
    [LightSwitch.PcbDoc, Logic.SchDoc, Power.SchDoc, SeniorProject-Unused.PcbLib, SeniorProject-Unused.SchLib, SeniorProject.PrjPCB, SeniorProject.SchLib, XBee.SchDoc]
2018-03-22 moved lightswitch mechanical files to folder
    [1GangSwitchBox.STEP, 1GangSwitchBox.ipt, EncoderDaughter.step, LightSwitchCover 1.0.stl, LightSwitchCover.ipt, PEC11-4215F-S24.stp]
2018-03-22 added thermostat adc sampling, added (commented out) lightswitch 1.0 pcb pins
2018-03-22 set front chamfer to 45degrees, added chamfer to exterior mounting holes, enlarged pcb mounting screw holes
    [LightSwitchCover.ipt]
2018-03-22 moved rpi connector to avoid board touching rpi jacks
    [Control.SchDoc, Hub.PcbDoc, Rpi.SchDoc]
2018-03-22 made SMD pin 1 indicators bigger, fixed relay control circuit, resized poly pours
    [Dimmer.SchDoc, LightSwitch.PcbDoc, SeniorProject.PcbLib]
2018-03-22 made 0603 pin 1 indicator larger
    [Hub.PcbDoc, Hub.PcbLib]
2018-03-23 fixed relay control circuits, modified pcb accordingly
    [Control.SchDoc, Hub.PcbDoc, Power.SchDoc, Xbee.SchDoc]
2018-03-23 made light 1.0 pcb dimming function
2018-03-25 replaced CT with ic, rerouted flipflop and schmitt, added testpoints
    [Dimmer.SchDoc, LightSwitch.PcbDoc, Logic.SchDoc, Power.SchDoc, SeniorProject.PcbLib, SeniorProject.PrjPCB, SeniorProject.SchLib, XBee.SchDoc]
2018-03-25 fixed silk, reannotated, added more testpoints
    [Control.SchDoc, Hub.PcbDoc, Hub.PcbLib, Hub.PrjPCB, Hub.SchLib, Power.SchDoc, Rpi.SchDoc, Xbee.SchDoc]
2018-03-25 resized poly pours, generated pdfs and BOM, removed 1.0 files
    [Dimmer.SchDoc, LightSwitch.PcbDoc, Lightswitch 1.0 BOM.xlsx, Lightswitch 1.1 BOM.xlsx, Power.SchDoc, SeniorProject-Unused.PcbLib, SeniorProject-Unused.SchLib, SeniorProject.PcbLib]
2018-03-25 fixed xbee silk outline
    [Control.SchDoc, Hub.PcbDoc, Hub.PcbLib, Hub.PrjPCB, Power.SchDoc, Rpi.SchDoc, Xbee.SchDoc]
2018-03-25 fixed board outline silk width
    [LightSwitch.PcbDoc, SeniorProject.PrjPCB]
2018-03-25 added panelized output files, removed lightswitch testpoint designators
    [Hub 1.0 BOM.xlsx, LightSwitch.PcbDoc, PanelizedBoards.PrjPCB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]
2018-03-25 init commit of hub mechanical parts
    [Hub 1.0 BOM.xlsx, Hub Enclosure.ipt, PanelizedBoards.PrjPCB, Standoff.ipt, Touchscreen PCB.ipt, Touchscreen.ipt]
2018-03-25 added enclosure back, added gangbox
    [1GangSwitchBox.ipt, Hub Enclosure Back.ipt, Hub Enclosure Front.ipt, Hub Enclosure.ipt]
2018-03-26 enclosure stuff
    [Hub Enclosure Back.ipt, Hub Enclosure Front (new).ipt]
2018-03-27 generated stls
    [Hub Enclosure Back 1.0.stl, Hub Enclosure Front 1.0.stl, LightSwitchCover 1.1.stl]
2018-03-27 added daughterboard stabilizers
    [LightSwitchCover 1.1.stl, LightSwitchCover.ipt]
2018-03-29 added string parsing for any device names
2018-03-29 added temperature sense calculation, commented out user tasks support
2018-04-02 added holes to PCB step, removed snap fit, added slots to screen mounting holes
    [Hub Enclosure Back 1.0.stl, Hub Enclosure Back 1.1.stl, Hub Enclosure Back.ipt, Hub Enclosure Front (new).ipt, Hub Enclosure Front 1.1.stl]
2018-04-02 forgot to save changes
    [Hub Enclosure Back.ipt, Hub Enclosure Front (new).ipt]
2018-04-03 un-exploded assemblies, added renderings
    [Touchscreen.ipt]
2018-04-07 fixed lightswitch relay control, fixed thermostat logic
    [home.py, server_main.py]
2018-04-08 moved constants back to home.py, added custom output device support
2018-04-12 added custom device types, added gui control tab
2018-04-12 fixed custom switch functionality, added power plotter script
    [home.py]
2018-04-24 fixed button pull up resistor
    [LightSwitch.PcbDoc, Logic.SchDoc, SeniorProject.PrjPCB]
